eSpark-Backup/ezlo-ambienttrackerpro/README.md

# ezlo-ambienttrackerpro
Convert and do corrections in Ambient Tracker Pro design
