eSpark-Backup/ezlo-ambienttrackerpro/Design-Files/Main-Board-v1.0/BOM/eSpark-BOM-Main-Board-v1.0.xlsx

 |  | Component list |  | Bill of Materials for Project [Main-Board-v1.0]
 |  | Source Data From: |  | Main-Board-v1.0
 |  | Project: |  | Main-Board-v1.0
 |  | Variant: |  | None
# | Item Type | Designator | Description | Footprint | Manufacturer Part Number | Manufacturer | Alternate Part Number | LCSC Part Number | Value | Quantity | Quantity (5 Boards) | MOQ (5 Boards) | Links | Unit Cost (5 Boards) | Total Cost (5 Boards) | Remarks | Reviewer Remarks
1 | Capacitor | C1, C3, C35 | CAP CER 0.1UF 100V X7R 0603 | Cap-0603 | CC0603KRX7R0BB104 | Yageo | - | C113803 | 0.1uF | 3 | 15 | 100 | LCSC (https://www.lcsc.com/product-detail/Multilayer-Ceramic-Capacitors-MLCC-SMD-SMT_YAGEO-CC0603KRX7R0BB104_C113803.html) | $0.0050 | $0.5000
2 | Capacitor | C2 | 15uF 160V ±20% SMD,D10xL10.2mm Aluminum Electrolytic Capacitors - SMD ROHS | Custom | UD2C150M1010 | Honor Elec | - | C98557 | 15uF | 1 | 5 | 10 | LCSC (https://www.lcsc.com/product-detail/Aluminum-Electrolytic-Capacitors-SMD_Honor-Elec-UD2C150M1010_C98557.html) | $0.1212 | $1.2120
3 | Capacitor | C4 | CAP CER 12PF 50V C0G/NPO 0603 | Cap-0603 | CC0603JRNPO9BN120 | Yageo | - | C107034 | 12pF | 1 | 5 | 100 | LCSC (https://www.lcsc.com/product-detail/Multilayer-Ceramic-Capacitors-MLCC-SMD-SMT_YAGEO-CC0603JRNPO9BN120_C107034.html) | $0.0028 | $0.2800
4 | Capacitor | C5 | 470uF 16V ±20% SMD,D8xL10mm Aluminum Electrolytic Capacitors - SMD ROHS | Custom | VZH471M1CTR-0810 | Lelon |  | C164069 | 470uF | 1 | 5 | 10 | LCSC (https://www.lcsc.com/product-detail/Aluminum-Electrolytic-Capacitors-SMD_Lelon-VZH471M1CTR-0810_C164069.html) | $0.1017 | $1.0170
5 | Capacitor | C6, C7, C10, C12, C14, C15, C17, C20, C21, C23, C26, C27, C31, C32, C34, C39, C40, C41, C42, C43, C44, C55, C56 | CAP CER 0.1UF 50V X5R 0402 | Cap-0402 | C1005X5R1H104K050BB | TDK |  | C2181865 | 0.1uF | 23 | 115 |  |  |  | $0.0000
6 | Capacitor | C8 | CAP ALUM 100UF 20% 10V SMD | Custom | UCD1A101MCL1GS | Nichicon |  | C340720 | 100uF | 1 | 5 | 10 | LCSC (https://www.lcsc.com/product-detail/Aluminum-Electrolytic-Capacitors-SMD_Nichicon-UCD1A101MCL1GS_C340720.html) | $0.1604 | $1.6040
7 | Capacitor | C9, C24, C25, C38, C45 | CAP CER 10UF 16V X5R 0603 | Cap-0603 | CC0603KRX5R7BB106 | Yageo |  | C2936601 | 10uF | 5 | 25 |  |  |  | $0.0000
8 | Capacitor | C11 | CAP CER 4700PF 1KV X7R 1206 | Cap-1206 | CC1206KKX7RCBB472 | Yageo |  | C107198 | 4.7nF | 1 | 5 | 50 | LCSC (https://www.lcsc.com/product-detail/Multilayer-Ceramic-Capacitors-MLCC-SMD-SMT_YAGEO-CC1206KKX7RCBB472_C107198.html) | $0.0172 | $0.8600
9 | Capacitor | C13, C16, C18, C19, C22 | CAP CER 10UF 10V X5R 0402 | Cap-0402 | CC0402MRX5R6BB106 | Yageo |  | C962143 | 10uF | 5 | 25 | 40 | LCSC (https://www.lcsc.com/product-detail/Multilayer-Ceramic-Capacitors-MLCC-SMD-SMT_YAGEO-CC0402MRX5R6BB106_C962143.html) | $0.0263 | $1.0520
10 | Capacitor | C30 | CAP CER 22UF 10V X5R 0603 | Cap-0603 | CC0603MRX5R6BB226 | Yageo |  | C109447 | 22uF | 1 | 5 | 20 | LCSC (https://www.lcsc.com/product-detail/Multilayer-Ceramic-Capacitors-MLCC-SMD-SMT_YAGEO-CC0603MRX5R6BB226_C109447.html) | $0.0339 | $0.6780
11 | Capacitor | C33 | CAP CER 1UF 10V X5R 0402 | Cap-0402 | CC0402KRX5R6BB105 | Yageo |  | C106254 | 1uF | 1 | 5 | 100 | LCSC (https://www.lcsc.com/product-detail/Multilayer-Ceramic-Capacitors-MLCC-SMD-SMT_YAGEO-CC0402KRX5R6BB105_C106254.html) | $0.0025 | $0.2500
12 | Capacitor | C36, C37 | CAP CER 22UF 25V X5R 0805 | Cap-0805 | CC0805MKX5R8BB226 | Yageo |  | C784585 | 22uF | 2 | 10 | 20 | LCSC (https://www.lcsc.com/product-detail/Multilayer-Ceramic-Capacitors-MLCC-SMD-SMT_YAGEO-CC0805MKX5R8BB226_C784585.html) | $0.0659 | $1.3180
13 | Capacitor | C46, C47 | 50V 6.8nF X7R ±10% 0603 | Cap-0603 | 0603B682K500NT | FH |  | C1631 | 6.8nF | 2 | 10 | 100 | LCSC (https://www.lcsc.com/product-detail/Multilayer-Ceramic-Capacitors-MLCC-SMD-SMT_FH-Guangdong-Fenghua-Advanced-Tech-0603B682K500NT_C1631.html) | $0.0026 | $0.2600
14 | Capacitor | C48, C50 | CAP CER 10000PF 50V C0G/NPO 0603 | Cap-0603 | CC0603JRNPO9BN103 | Yageo |  | C389113 | 10nF | 2 | 10 | 50 | LCSC (https://www.lcsc.com/product-detail/Multilayer-Ceramic-Capacitors-MLCC-SMD-SMT_YAGEO-CC0603JRNPO9BN103_C389113.html) | $0.0146 | $0.7300
15 | Capacitor | C49 | CAP CER 0.022UF 50V X7R 0603 | Cap-0603 | CC0603KRX7R9BB223 | Yageo |  | C106222 | 22nF | 1 | 5 | 100 | LCSC (https://www.lcsc.com/product-detail/Multilayer-Ceramic-Capacitors-MLCC-SMD-SMT_YAGEO-CC0603KRX7R9BB223_C106222.html) | $0.0031 | $0.3100
16 | Capacitor | C51 | CAP CER 4.7UF 10V X5R 0603 | Cap-0603 | CC0603KRX5R6BB475 | Yageo |  | C109456 | 4.7uF | 1 | 5 | 50 | LCSC (https://www.lcsc.com/product-detail/Multilayer-Ceramic-Capacitors-MLCC-SMD-SMT_YAGEO-CC0603KRX5R6BB475_C109456.html) | $0.0149 | $0.7450
17 | Capacitor | C52, C53 | Multilayer Ceramic Capacitor, 12 pF, 50 V, ± 5%, C0G (NP0), 0201 [0603 Metric] | CAP-0201 | GRM0335C1H120JA01D | Murata |  | C85890 | 12pF | 2 | 10 | 100 | LCSC (https://www.lcsc.com/product-detail/Multilayer-Ceramic-Capacitors-MLCC-SMD-SMT_Murata-Electronics-GRM0335C1H120JA01D_C85890.html) | $0.0020 | $0.2000
18 | Capacitor | C54 | CAP CER 1000PF 2KV X7R 1206 | Cap-1206 | CC1206KKX7RDBB102 | Yageo |  | C23631 | 1000pF | 1 | 5 | 50 | LCSC (https://www.lcsc.com/product-detail/Multilayer-Ceramic-Capacitors-MLCC-SMD-SMT_YAGEO-CC1206KKX7RDBB102_C23631.html) | $0.0148 | $0.7400
19 | ~~Capacitor~~ | ~~C?~~ | ~~100V 220pF X7R ±10% 0603 Multilayer Ceramic Capacitors MLCC - SMD/SMT ROHS~~ | ~~Cap-0603~~ | ~~0603B221K101NT~~ | ~~FH~~ |  | ~~C313082~~ | ~~DNP~~ | ~~1~~ | ~~5~~ | ~~-~~ |  | ~~-~~ | ~~-~~ | ~~Do Not Place~~
20 | Diode | D2 | 93.6V 64.4V 58V SMA(DO-214AC) TVS ROHS | SMA | SMAJ58A | Yangzhou Yangjie Elec Tech |  | C698958 |  | 1 | 5 | 10 | LCSC (https://www.lcsc.com/product-detail/TVS_Yangzhou-Yangjie-Elec-Tech-SMAJ58A_C698958.html) | $0.0463 | $0.4630
21 | Diode | D3 | SCHOTTKY DIODE SMB 100V 5A | SMB_ | SS510B | MDD |  | C3011128 |  | 1 | 5 | 10 | LCSC (https://www.lcsc.com/product-detail/Schottky-Barrier-Diodes-SBD_JUXING-SS510B_C3011128.html) | $0.0267 | $0.2670
22 | Diode | D4 | SOD-123FL Schottky Barrier Diodes (SBD) ROHS | SOD-123FL | PMEG4030ER | Shikues |  | C5366303 |  | 1 | 5 | 10 | LCSC (https://www.lcsc.com/product-detail/Schottky-Barrier-Diodes-SBD_Shikues-PMEG4030ER_C5366303.html) | $0.0519 | $0.5190
23 |  | D5 | ESD Suppressor TVS 5.5V 4-Pin(3+Tab) SOT-143 T/R | SOT-143-4_ | SP0503BAHTG | Littelfuse |  | C3029025 |  | 1 | 5 | 10 | LCSC (https://www.lcsc.com/product-detail/ESD-Protection-Devices_MSKSEMI-SP0503BAHTG-MS_C3029025.html) | $0.0865 | $0.8650
24 | Fuse | F1, F2 | 6V 2A 50A 1W -40℃~+85℃ 4A 4mΩ 5s 45mΩ 0805 Resettable Fuses ROHS | Fuse-0805 | BSMD0805L-200 | BHFUSE |  | C2757931 |  | 2 | 10 | 15 | LCSC (https://www.lcsc.com/product-detail/Resettable-Fuses_BHFUSE-BSMD0805L-200_C2757931.html) | $0.0930 | $1.3950
25 | Ferrite Bead | FB1, FB4 | FERRITE BEAD 120 OHM 0603 1LN | IND-0603 (1608 Metric) | BLM18SG121TN1D | Murata |  | C113030 |  | 2 | 10 | 20 |  |  | $0.0000
26 | Ferrite Bead | FB2, FB3, FB7, FB8 | FERRITE BEAD 120 OHM 0402 1LN | IND-0402 | BLM15PD121SN1D | Murata |  | C76891 |  | 4 | 20 |  |  |  | $0.0000
27 | Ferrite Bead | FB5, FB6 | 100mΩ ±25% 600Ω@100MHz 0805 Ferrite Beads ROHS | Ind-0805 | CBM201209U601T | FH |  | C139168 |  | 2 | 10 |  |  |  | $0.0000
28 | USB Connector | J1 | 250mA 1 16 Female Type-C SMD USB Connectors ROHS | TYPE-C-31-M-12_ | TYPE-C-31-M-12 | Korean Hroparts Elec |  | C165948 |  | 1 | 5 |  |  |  | $0.0000
29 | FFC/FPC Connector | J2 | Clamshell 14P Bottom Contact Surface Mount 0.5mm SMD,P=0.5mm FFC/FPC Connectors ROHS | AFC01-S14FCC-00 | AFC01-S14FCC-00 | JUSHUO |  | C577443 |  | 1 | 5 |  |  |  | $0.0000
30 | R/A Male Blade Header | J3 | CONN HEADER SMD R/A 8POS 1.25MM | 53261-0871 | 53261-0871 | Molex |  |  |  | 1 | 5 |  |  |  | $0.0000
31 | Connector | J4 | 1x6P SH 1 1mm 6 SMD,P=1mm Wire To Board / Wire To Wire Connector ROHS | Voltlink Target | C145963 | BOOMELE |  | C145963 |  | 1 | 5 |  |  |  | $0.0000
32 | Ethernet Connector | J5 | 1x1 Port Tab-UP RJ45 Connector with Integrated Magnetics and LED for 10/100Base-T PoE application | HR873170C | HR873170C | Hanrun |  |  |  | 1 | 5 |  |  |  | $0.0000
33 | Inductor | L1 | 3A 33uH ±20% 64.8mΩ SMD,12.3x12.3mm Inductors (SMD) ROHS | CYH127-33UH | CYH127-33UH | SHOU HAN |  | C2929502 | 33uH | 1 | 5 |  |  |  | $0.0000
34 | Inductor | L2 | FIXED IND 10UH 1A 540 MOHM SMD | IND-1008 (2520 Metric) | VLS252012HBX-100M-1 | TDK |  | C88532 | 10uH | 1 | 5 |  |  |  | $0.0000
35 | RGB LED | LED1 | 5mA -40℃~+80℃ RGB SMD,2x2mm Light Emitting Diodes (LED) ROHS | SK6812-EC20 | SK6812-EC20 | OPSCO Optoelectronics |  | C2909058 |  | 1 | 5 |  |  |  | $0.0000
36 | LED | LED2 | LED GREEN CLEAR CHIP SMD | LED-0402 | XZVG68W-2 | SunLED |  |  |  | 1 | 5 |  |  |  | $0.0000
37 | TEST POINT | P1, P2, P3, P4, P5, P6, P7, P8, P9, P10, P11, P12, P13, P14, P15, P16, P17, P18, P19, P20, P21, P22, P23, P24, P25, P26, P27, P28, P29, P30, P31, P32, P33 | Test Point ON | Test-point |  |  |  |  |  | 33 | 165 |  |  |  | $0.0000
38 | Mosfet | Q1 | SOT-23-3 MOSFETs ROHS | SOT-23 | SI2323DS | TECH PUBLIC |  | C5182044 |  | 1 | 5 |  |  |  | $0.0000
39 | Mosfet | Q2 | N-CHANNEL 20-V (D-S) MOSFET | Sot-23 | SI2302CDS | TECH PUBLIC |  | C5310968 |  | 1 | 5 |  |  |  | $0.0000
40 | Mosfet | Q3 | NPN 246mW 100mA 50V SOT-23 Digital Transistors ROHS | SOT-23 | LMUN2211LT1G | LRC |  | C12775 |  | 1 | 5 |  |  |  | $0.0000
41 | Mosfet | Q4 | 20V 2.2A 800mW 110mΩ@4.5V,2.7A 810mV@250uA P Channel SOT-23 MOSFETs ROHS | Sot-23 | WPM2015-3/TR | WILLSEMI |  | C213159 |  | 1 | 5 |  |  |  | $0.0000
42 | Resistor | R1 | RES 4.7 OHM 1% 1/10W 0603 | Res-0603 | RC0603FR-074R7L | Yageo |  | C137705 | 4.7R | 1 | 5 |  |  |  | $0.0000
43 |  | R2 | RES SMD 24.9K OHM 1% 1/5W 0402 | Res-0402 | RCS040224K9FKED | Vishay Dale |  | C1881100 | 24.9K | 1 | 5 |  |  |  | $0.0000
44 | Resistor | R3, R23, R24 | RES SMD 4.7K OHM 1% 1/10W 0603 | Res-0603 | RC0603FR-074K7L | Yageo |  | C99782 | 4.7K | 3 | 15 |  |  |  | $0.0000
45 | Resistor | R4 | RES 0.03 OHM 1% 1/2W 0805 | RES-0805 | PE0805FRF470R03L | Yageo |  | C858599 | 30mR | 1 | 5 |  |  |  | $0.0000
46 | Resistor | R5 | RES SMD 301 OHM 0.1% 1/10W 0603 | Res-0603 | RT0603BRE07301RL | YAGEO |  | C861824 | 301R | 1 | 5 |  |  |  | $0.0000
47 | Resistor | R6 | RES 180K OHM 1% 1/10W 0603 | Res-0603 | RC0603FR-07180KL | Yageo |  | C123419 | 180K | 1 | 5 |  |  |  | $0.0000
48 | Resistor | R7 | RES SMD 4.42K OHM 1% 1/10W 0603 | Res-0603 | AC0603FR-074K42L | Yageo |  | C227930 | 4.42K | 1 | 5 |  |  |  | $0.0000
49 | Resistor | R8 | RES SMD 57.6KOHM 0.1% 1/10W 0603 | Res-0603 | RT0603BRE0757K6L | YAGEO |  | C849817 | 57.6K | 1 | 5 |  |  |  | $0.0000
50 | Resistor | R9, R17, R18, R19, R27, R36, R38 | RES 10K OHM 1% 1/16W 0402 | Res-0402 | RC0402FR-0710KL | Yageo |  | C60490 | 10K | 7 | 35 |  |  |  | $0.0000
51 | Resistor | R10, R25 | RES 100K OHM 5% 1/10W 0603 | Res-0603 | RC0603JR-07100KL | Yageo |  | C100048 | 100K | 2 | 10 |  |  |  | $0.0000
52 | Resistor | R11, R12 | RES 5.1K OHM 1% 1/16W 0402 | Res-0402 | RC0402FR-075K1L | Yageo |  | C137973 | 5.1K | 2 | 10 |  |  |  | $0.0000
53 | Resistor | R13 | RES SMD 1M OHM 1% 1/10W 0603 | Res-0603 | RC0603FR-071ML | Yageo |  | C105578 | 1M | 1 | 5 |  |  |  | $0.0000
54 | Resistor | R14, R15, R21 | RES SMD 10K Ohm 1% 1/10W 0603 | Res-0603 | RC0603FR-0710KL | Yageo |  | C98220 | 10K | 3 | 15 |  |  |  | $0.0000
55 | Resistor | R20, R22, R26 | RES SMD 1K OHM 1% 1/10W 0603 | Res-0603 | RC0603FR-071KL | Yageo |  | C22548 | 1K | 3 | 15 |  |  |  | $0.0000
56 | Resistor | R28 | RES SMD 0R, 1%, 0.1W, 0603 | Res-0603 | RC0603FR-070RL | Yageo |  | C100044 | DNP | 1 | 5 |  |  |  | $0.0000
57 | Resistor | R29, R30, R31, R34 | RES SMD 0603 33 Ohm 1% 1/10W | Res-0603 | RC0603FR-0733RL | Yageo |  | C108661 | 33R | 4 | 20 |  |  |  | $0.0000
58 | Resistor | R32, R33, R35, R37 | RES 49.9 OHM 1% 1/10W 0603 | Res-0603 | RC0603FR-0749R9L | Yageo |  | C114625 | 49.9R | 4 | 20 |  |  |  | $0.0000
59 | Resistor | R39 | RES SMD 10 OHM 1% 1/10W 0603 | Res-0603 | RC0603FR-0710RL | Yageo |  | C109318 | 10R | 1 | 5 |  |  |  | $0.0000
60 | Resistor | R40 | Res Thick Film 0402 1M Ohm 1% 0.1W(1/10W) ±100ppm/C Pad SMD Automotive T/R | Res-0402 | RK73H1ETTP1004F | KOA Speer |  | C159943 | 1M | 1 | 5 |  |  |  | $0.0000
61 | Resistor | R41, R43 | RES SMD 330R 100 mW 0603 | Res-0603 | RC0603JR-07330RL | Yageo |  | C105879 | 330R | 2 | 10 |  |  |  | $0.0000
62 | Resistor | R42, R45 | RES SMD 0R, 1%, 0.1W, 0603 | Res-0603 | RC0603FR-070RL | Yageo |  | C100044 | 0R | 2 | 10 |  |  |  | $0.0000
63 | Resistor | R44 | RES SMD 12.4K OHM 1% 1/10W 0603 | Res-0603 | RC0603FR-0712K4L | Yageo |  | C137798 | 12.4K | 1 | 5 |  |  |  | $0.0000
64 | Resistor | R? | RES 22 OHM 1% 1/16W 0402 | Res-0402 | RC0402FR-0722RL | Yageo |  | C114765 | DNP | 1 | 5 |  |  |  | $0.0000
65 | Resistor Array | RN1, RN2, RN3 | RES ARRAY 4 RES 10K OHM 1206 | YC164-FR-0710KL | YC164-FR-0710KL | Yageo |  | C110924 | 10K | 3 | 15 |  |  |  | $0.0000
66 | Tactile Switch | SW1 | 50mA 100MΩ 100000 Times 260gf@±50gf 12V Surface Mount SPST SMD Tactile Switches ROHS | TP12422673 | TP12422673 | ROCPU Switch |  | C5381384 |  | 1 | 5 |  |  |  | $0.0000
67 | IC | U1 | Step-down type SOIC-8-EP DC-DC Converters ROHS | 8-SOIC-EP | TX4138 | XDS |  | C329267 |  | 1 | 5 |  |  |  | $0.0000
68 | IC | U2 | IC POE CNTRL 1 CHANNEL 8SOIC | SOIC-8 | TPS2375DR | Texas Instruments |  | C2867397 |  | 1 | 5 |  |  |  | $0.0000
69 | IC | U3 | 600mA 60dB 500mV@(600mA) Fixed 3.3V~3.3V Positive 1 7V SOT-89(SOT-89-3) Linear Voltage Regulators (LDO) ROHS | SOT-89-3 | LR1107G-33-AB3-C-R | UTC(Unisonic Tech) |  | C171498 |  | 1 | 5 |  |  |  | $0.0000
70 | IC | U4 | 300mA 80dB@(1kHz) 410mV@(300mA) Fixed 1.8V~1.8V Positive 1 5.5V SOT-25-5 Linear Voltage Regulators (LDO) ROHS | SOT-25-5 | XC6228D182VR-G | Torex Semicon |  | C216644 |  | 1 | 5 |  |  |  | $0.0000
71 | IC | U5 | 300mA 80dB@(1kHz) 305mV@(300mA) Fixed 3.3V~3.3V Positive 1 5.5V SOT-25-5 Linear Voltage Regulators (LDO) ROHS | SOT-25-5 | XC6228D332VR-G | Torex Semicon |  | C69841 |  | 1 | 5 |  |  |  | $0.0000
72 | Temperature Sensor | U7 | SENSOR RH PRESSURE TEMP VOC | BME680 | BME680 | Bosch Sensortec |  | C125972 |  | 1 | 5 |  |  |  | $0.0000
73 | Module | U8 | SMD MODULE, ESP32-S3R8 WITH 3.3V | 41-SMD Module | ESP32-S3-WROOM-1-N16R8 | Espressif Systems |  | C2913202 |  | 1 | 5 |  |  |  | $0.0000
74 | Module | U9 | RF Modules ENGINEERING SAMPLE | DWM3000_ESSR | DWM3000-ESSR | Qorvo |  |  |  | 1 | 5 |  |  |  | $0.0000
75 | IC | U10 | SPI LQFP-48(7x7) Ethernet ICs ROHS | 48-LQFP (7x7)_ | W5500 | WIZNET |  | C32843 |  | 1 | 5 |  |  |  | $0.0000
76 | TVS Diode | U11 | TVS DIODE 5.5VWM 8.5VC SOT23-5 | SOT-23-5 | SP0504BAHTG | Littelfuse |  | C10675 |  | 1 | 5 |  |  |  | $0.0000
77 | IC | U12 | IC TRANSLATOR BIDIR 20TSSOP | TSSOP-20 | TXS0108EPWR | Texas Instruments |  | C17206 |  | 1 | 5 |  |  |  | $0.0000
78 | Crystal | X1 | CRYSTAL 25.0000MHZ 12PF SMD | Q22FA12800090 | Q22FA12800090 | Seiko Epson |  | C255883 | 25MHz | 1 | 5 |  |  |  | $0.0000
 |  |  |  |  |  |  |  |  |  |  |  | Total Component Cost |  |  | #REF!
 |  |  |  |  |  |  |  |  |  |  |  | Single Board Cost |  |  | #REF!
