eSpark-Backup/ezlo-ambienttrackerpro/Client-Files/Ambient Tracker PRO/BOM/JLCSMT_BOM_tracker_revA.xlsx

Comment | Designator | Footprint | LCSC Part #（optional）
0.1uF | C1, C2, C9, C11, C13, C14, C16, C18, C19, C20, C21, C25, C30, C31, C34, C35, C36, C37, C46, C47, C48, C50, C51, C52, C54, | Capacitor_SMD:C_0402_1005Metric | C307331
1uF | C3, C32, | Capacitor_SMD:C_0402_1005Metric | C52923
10uF | C4, C5, C26, C45, C55, | Capacitor_SMD:C_0603_1608Metric | C92487
10uF | C6, C8, C12, C17, C24, | Capacitor_SMD:C_0402_1005Metric | C315248
4.7nF | C7, | Capacitor_SMD:C_1206_3216Metric | C107198
0.1uF | C10, C22, | Capacitor_SMD:C_0603_1608Metric | C15725
15uF | C15, | Capacitor_SMD:CP_Elec_10x10 | C473415
220pF | C23, | Capacitor_SMD:C_0603_1608Metric | DNP | C472787
12pF | C27, C56, C57, | Capacitor_SMD:C_0402_1005Metric | C1547
470uF | C28, | Capacitor_SMD:CP_Elec_8x10 | C164069
100uF | C29, | Capacitor_SMD:CP_Elec_6.3x5.8 | C340720
22uF | C33, | Capacitor_SMD:C_1206_3216Metric | C408152
1nF 2KV X7R | C38, | Capacitor_SMD:C_1206_3216Metric | C23631
6.8nF | C39, C40, | Capacitor_SMD:C_0402_1005Metric | C307331
22uF | C41, C44, | Capacitor_SMD:C_0603_1608Metric | C59461
10nF | C42, C49, | Capacitor_SMD:C_0402_1005Metric | C307331
22nF | C43, | Capacitor_SMD:C_0402_1005Metric | C307331
4.7uF | C53, | Capacitor_SMD:C_0603_1608Metric | C19666
SMAJ58A | D1, | Diode_SMD:D_SMA | C320541
SP0503BAHT | D2, | Package_TO_SOT_SMD:SOT-143 | C2682275
PMEG4030ER | D3, | Diode_SMD:D_SOD-123 | C389355
SS510 | D4, | Diode_SMD:D_SMC | C717458
LED_GREEN | D5, | LED_SMD:LED_0603_1608Metric | C84267
SK6812-EC20 | D6, | Ezlo:sk6812-2020 | C2909058
SP0504BAHT | D7, | Package_TO_SOT_SMD:SOT-23-5 | C2827708
1A | F1, F2, | Fuse:Fuse_0805_2012Metric | C369152
BLM18SG121TN1D | FB1, FB4, | Inductor_SMD:L_0603_1608Metric | C113030
BLM15PD121SN1B | FB2, FB3, FB5, FB6, | Inductor_SMD:L_0402_1005Metric | C76891
600R 3A | FB7, FB8, | Inductor_SMD:L_0805_2012Metric | C139168
Conn_01x10 | J1, | Ezlo:AFC01-S10FCC-00_1x10_P0.5mm_Horizontal | C262266
USB_C_Receptacle_USB2.0 | J3, | Ezlo:USB_C_Receptacle_HRO_TYPE-C-31-M-12 | C165948
VoltLink_target | J4, | Voltlog:VoltLink-vertical | C145963
10uH | L1, | Inductor_SMD:L_1008_2520Metric | C88532
33uH 2A | L2, | Inductor_SMD:L_Bourns_SRR1208_12.7x12.7mm | C2929502
SI2323DS | Q1, | Package_TO_SOT_SMD:SOT-23 | C693130
Si2302CDS | Q2, | Package_TO_SOT_SMD:SOT-23 | C10488
WPM2015-3 | Q3, | Package_TO_SOT_SMD:SOT-23 | C5246393
LMUN2211LT1G | Q4, | Package_TO_SOT_SMD:SOT-23 | C12775
10K | R1, R2, R3, R12, R19, R21, R24, R25, R30, R39, R41, | Resistor_SMD:R_0402_1005Metric | C25744
1M | R4, | Resistor_SMD:R_1206_3216Metric | C17927
5K1 | R5, R6, | Resistor_SMD:R_0402_1005Metric | C25905
180K | R7, | Resistor_SMD:R_0402_1005Metric | C284388
24K9 | R8, | Resistor_SMD:R_0402_1005Metric | C25874
4K42 | R9, | Resistor_SMD:R_0402_1005Metric | C517779
4K7 | R10, | Resistor_SMD:R_2512_6332Metric | C473645
0.03R | R11, | Resistor_SMD:R_1206_3216Metric | C473665
100K | R13, R27, | Resistor_SMD:R_0402_1005Metric | C25741
4R7 | R14, | Resistor_SMD:R_0402_1005Metric | C25169
22R | R15, | Resistor_SMD:R_0402_1005Metric | DNP | C25092
301K | R16, | Resistor_SMD:R_0402_1005Metric | C226978
57K6 | R17, | Resistor_SMD:R_0402_1005Metric | C26983
0R | R18, R42, | Resistor_SMD:R_0402_1005Metric | C17168
1K | R26, R34, | Resistor_SMD:R_0402_1005Metric | C25905
1K | R20 | Resistor_SMD:R_0402_1005Metric | DNP
4K7 | R22, R23, | Resistor_SMD:R_0402_1005Metric | C25900
330R | R28, R29, | Resistor_SMD:R_0402_1005Metric | C25104
0R | R31, | Resistor_SMD:R_0805_2012Metric | DNP | C17477
49R9 | R32, R33, R36, R37, | Resistor_SMD:R_0402_1005Metric | C25120
10R | R35, | Resistor_SMD:R_0402_1005Metric | C25077
12K4 | R38, | Resistor_SMD:R_0402_1005Metric | C11692
1M | R40, | Resistor_SMD:R_0402_1005Metric | C26083
0R | RN1, RN2, | Resistor_SMD:R_Array_Concave_4x0603 | C327053
33R | RN3, | Resistor_SMD:R_Array_Concave_4x0603 | C309681
10K | RN4, RN5, RN6, | Resistor_SMD:R_Array_Concave_4x0603 | C110924
USER | SW1, | Ezlo:Switch_YTS-B003-2A | C2910695
BME680 | U1, | Package_LGA:Bosch_LGA-8_3x3mm_P0.8mm_ClockwisePinNumbering | C125972
LTR-303ALS-01 | U2, | OptoDevice:Lite-On_LTR-303ALS-01 | C364577
XC6228D332VR-G | U3, | Package_TO_SOT_SMD:SOT-23-5 | C69841
TPS2375PW-1 | U4, | Package_SO:TSSOP-8_4.4x3mm_P0.65mm | C202190
XC6228D182VR-G | U5, | Package_TO_SOT_SMD:SOT-23-5 | C216644
TX4138 | U6, | Package_SO:Diodes_SO-8EP | C329267
LR1107 | U7, | Package_TO_SOT_SMD:SOT-89-3 | C171498
TXS0108EPWR | U8, | Package_SO:TSSOP-20_4.4x6.5mm_P0.65mm | C17206
ESP32-S3-WROOM-1-N8R2 | U9, | Espressif:ESP32-S3-WROOM-1 | C2913204
DWM3000 | U10, | Ezlo:Qorvo_DWM3000 | C5299931
W5500 | U11, | Package_QFP:LQFP-48_7x7mm_P0.5mm | C32843
25Mhz | Y1, | Crystal:Crystal_SMD_2016-4Pin_2.0x1.6mm | C255883
