eSpark-Backup/ezlo-ambienttrackerpro/Design-Files/Main-Board-v1.0/AmbientPro_Main_Board_V1.0.step

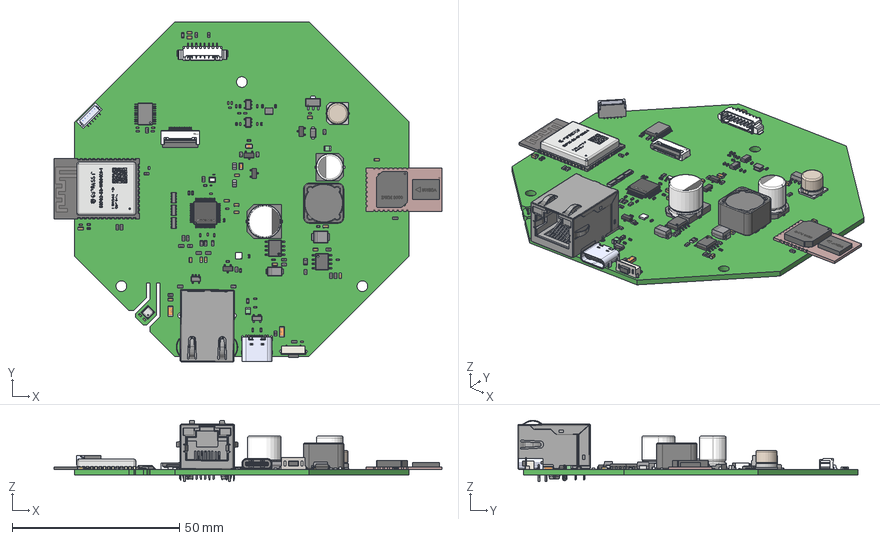
[picture p1: CAD file, 2023-11-29]
Design-Files/Main-Board-v1.0/AmbientPro_Main_Board_V1.0.step
115.9 x 101.7 x 18.3 mm
YC164-JR-070RL x 3
User Library-sot25 x 2
User Library-XRCGB27M000F2P00R0
TXS0108EPWR
SN74LV1T34DBVR
User Library-P-LQFP48-7x7-0_50
COMPOUND-49^DWM3000
ESP-S3-WROOM_via v3 x 26
ESP32-S3-WROOM_shell v11
ESP32-S3-WROOM_body v12
ESP-S3-WROOM_via v3(镜像) x 14
BME680--3DModel-STEP-56544
User_Library_SOT89_5005
User Library-SOIC-8-1 x 2
Switch
User Library-RES_1005-0402 x 12
User Library-RESC1608X05N x 32
User Library-CR2012-0805
CircuitWorks-SOT-23 x 4
User Library-LED-0402
OPSCO-Optoelectronics-SK6812-EC20_C2909058
VLS252012HBX-100M
SHOU HAN CYH127-33UH
HR873170C.dwg
SOLID.step.STEP.dwg.STEP.STEP.dwg
532610871--3DModel-STEP-269445
COMPOUND.step
TYPE-C-31-M-12
User Library-d0402h025 x 4
Lötende x 4
base x 2
User Library-fuse0805L050WR x 2
SP0503BAHTG--3DModel-STEP-56544 (1)
User Library-SOD-123FL CASE 498
User Library-DO-214AA SMB
User Library-DO-214AC SMA
User Library-CAPC1608X09 x 17
User Library-Capacitor 0402 x 29
User Library-1206 SMD Capacitor x 2
User Library-SMD Ceramic Capacitors_0201 (0603)_AB x 2
User Library-0805 SMD Capacitor x 2
UCD1A101MCL1GS3
SOLID.step
