eSpark-Backup/ezlo-ambienttrackerpro/Design-Files/Secondary-Board-v1.0/AmbientPro_Secondary_Board_V1.0.step

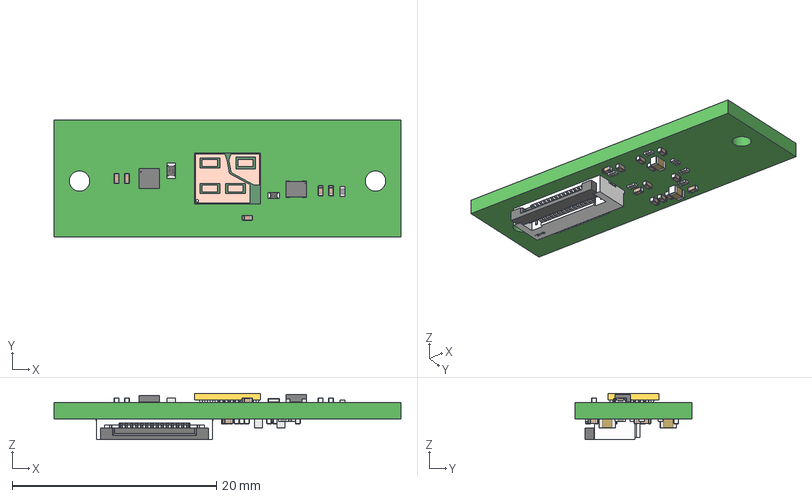
[picture p2: CAD file, 2023-11-29]
Design-Files/Secondary-Board-v1.0/AmbientPro_Secondary_Board_V1.0.step
34.0 x 11.5 x 4.51 mm
KC2016K_KYO
User Library-RES_1005-0402
User Library-Capacitor 0402 x 17
LTR-303ALS-01_LTO
User Library-RESC1608X05N
COMPOUND.step
User Library-d0402h025 x 7
User Library-CAPC1608X09 x 2
