eSpark-Backup/ezlo-ambienttrackerpro/Client-Files/Ambient Tracker PRO/sch-ambient-tracker-pro-revA.pdf

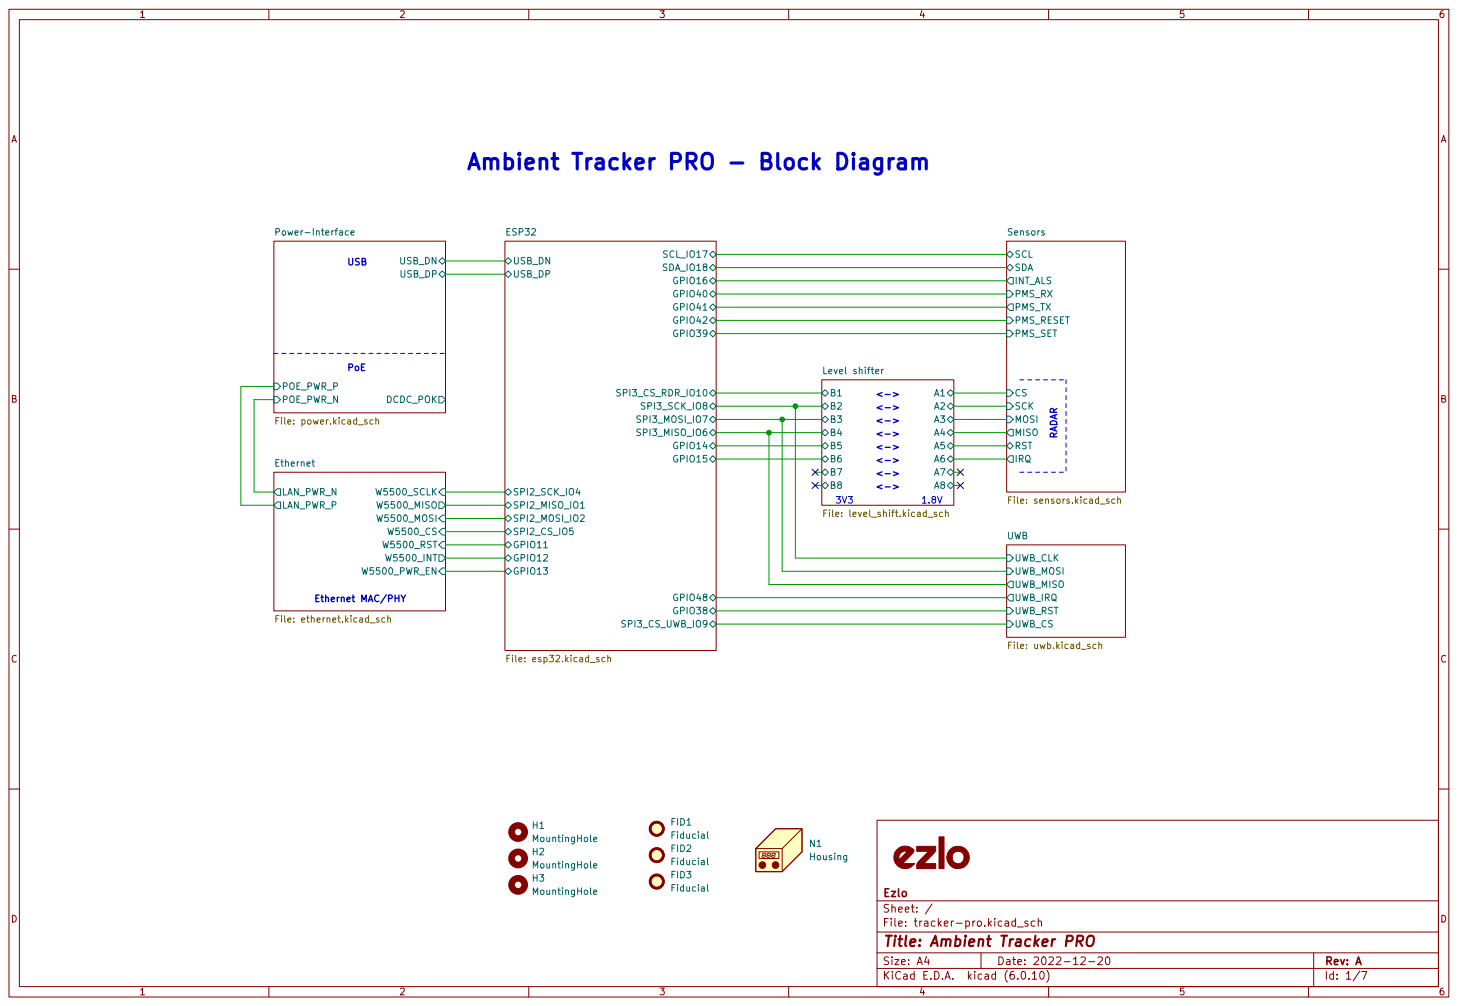
[picture p3: page 1]

<-> Ambient Tracker PRO - Block Diagram

File: tracker-pro.kicad_sch Sheet: / Ezlo

Id: 1/7 Title: Ambient Tracker PRO

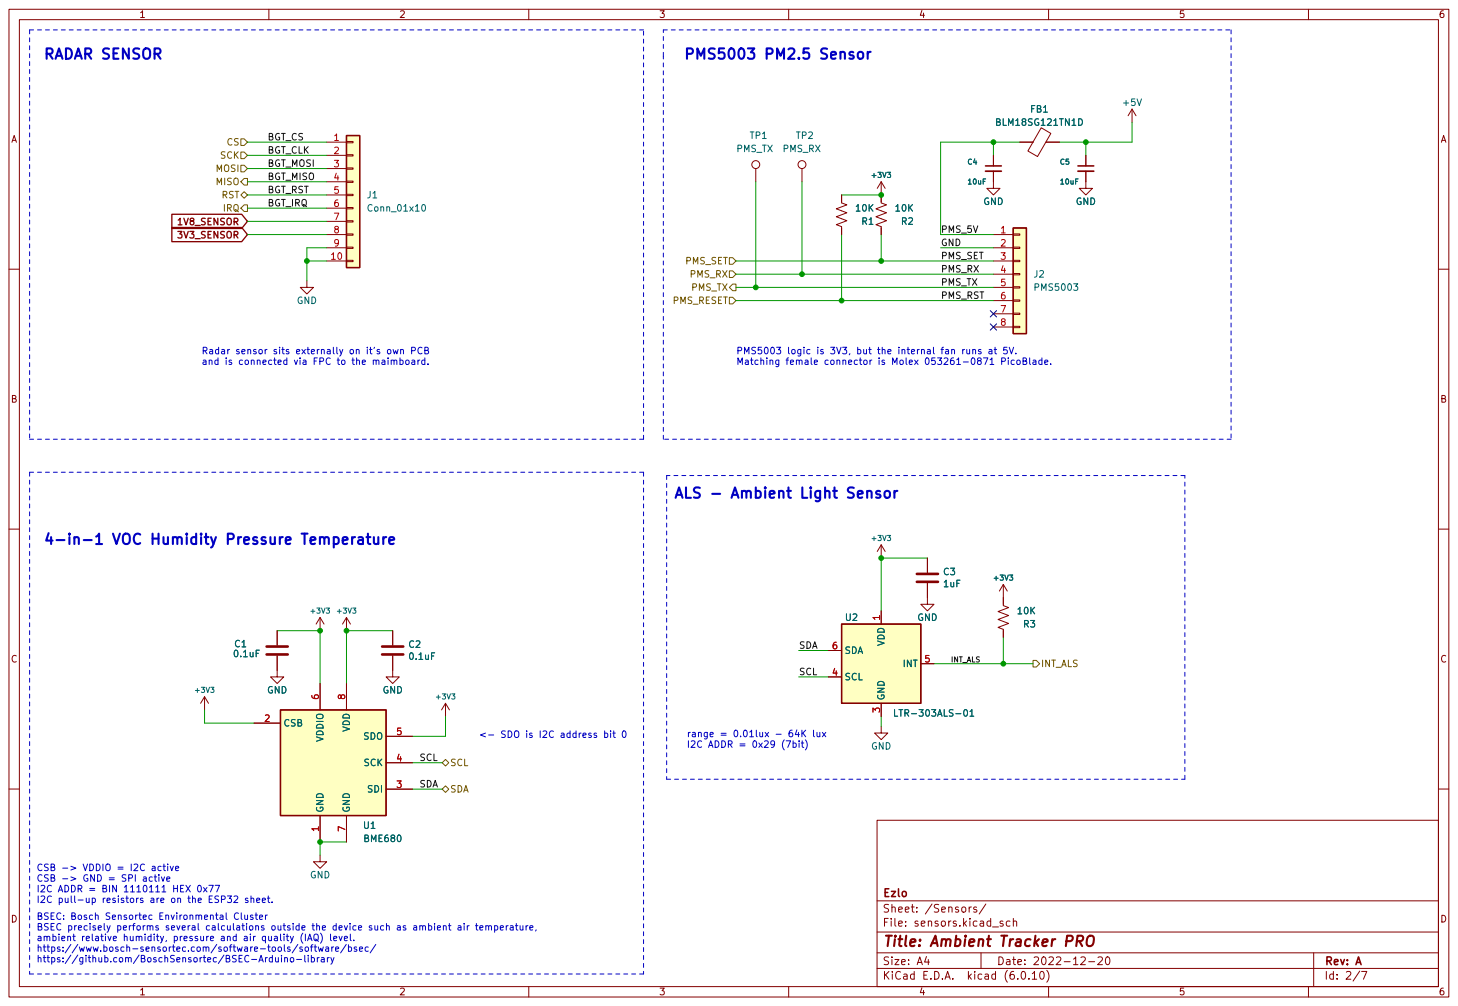
[picture p4: page 2]

and is connected via FPC to the maimboard. RADAR SENSOR

PMS_RESET PMS_RX MOSI SCK RST MISO

Matching female connector is Molex 053261-0871 PicoBlade. <- SDO is I2C address bit 0 Radar sensor sits externally on it's own PCB

PMS5003 logic is 3V3, but the internal fan runs at 5V.

ALS - Ambient Light Sensor

4-in-1 VOC Humidity Pressure Temperature

1 CSB 2 SDI 3 SCK 4 SDO 5 VDDIO

https://github.com/BoschSensortec/BSEC-Arduino-library CSB -> VDDIO = I2C active CSB -> GND = SPI active

I2C ADDR = BIN 1110111 HEX 0x77
I2C pull-up resistors are on the ESP32 sheet.
BSEC: Bosch Sensortec Environmental Cluster BSEC precisely performs several calculations outside the device such as ambient air temperature,
ambient relative humidity, pressure and air quality (IAQ) level.
https://www.bosch-sensortec.com/software-tools/software/bsec/

File: sensors.kicad_sch Sheet: /Sensors/ Ezlo

Id: 2/7 Title: Ambient Tracker PRO

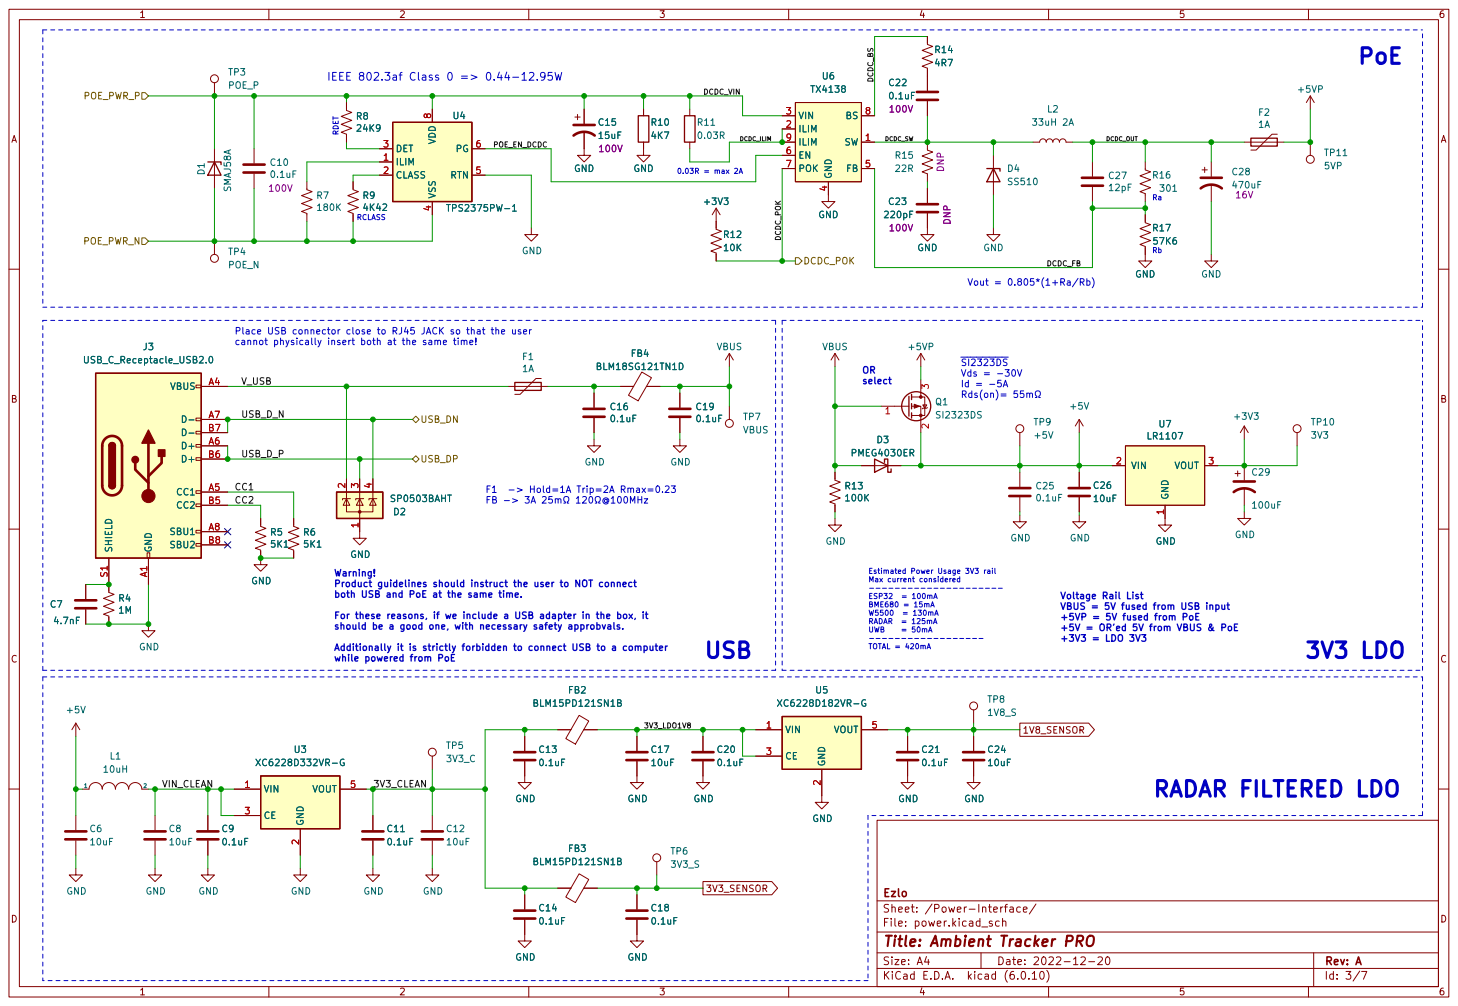
[picture p5: page 3]

TP3 POE_PGND
while powered from PoE RDET

4 FB 5 EN 6 POK 7 BS 8

RCLASS Place USB connector close to RJ45 JACK so that the user cannot physically insert both at the same time!

Warning!
Product guidelines should instruct the user to NOT connect both USB and PoE at the same time. For these reasons, if we include a USB adapter in the box, it

Estimated Power Usage 3V3 rail Max current considered

Voltage Rail List
VBUS = 5V fused from USB input +5VP = 5V fused from PoE

should be a good one, with necessary safety approbvals.

+5V = OR'ed 5V from VBUS & PoE

Additionally it is strictly forbidden to connect USB to a computer

File: power.kicad_sch Sheet: /Power-Interface/ Ezlo

Id: 3/7 Title: Ambient Tracker PRO

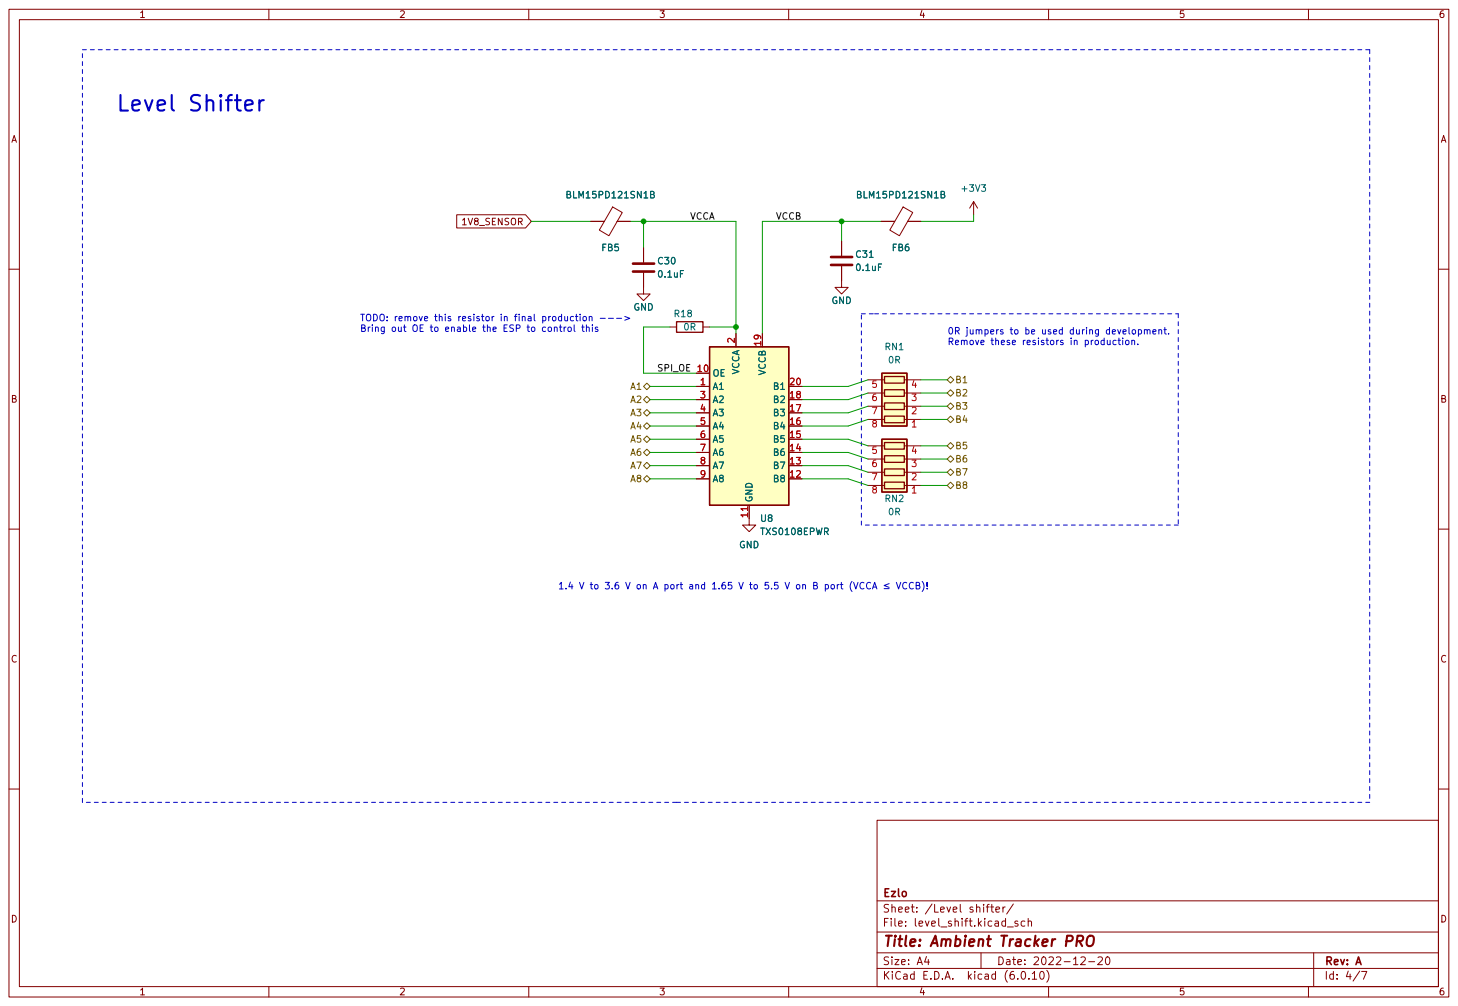
[picture p6: page 4]

TODO: remove this resistor in final production --->

0R jumpers to be used during development.
Remove these resistors in production.

File: level_shift.kicad_sch Sheet: /Level shifter/ Ezlo GND

Id: 4/7 Title: Ambient Tracker PRO

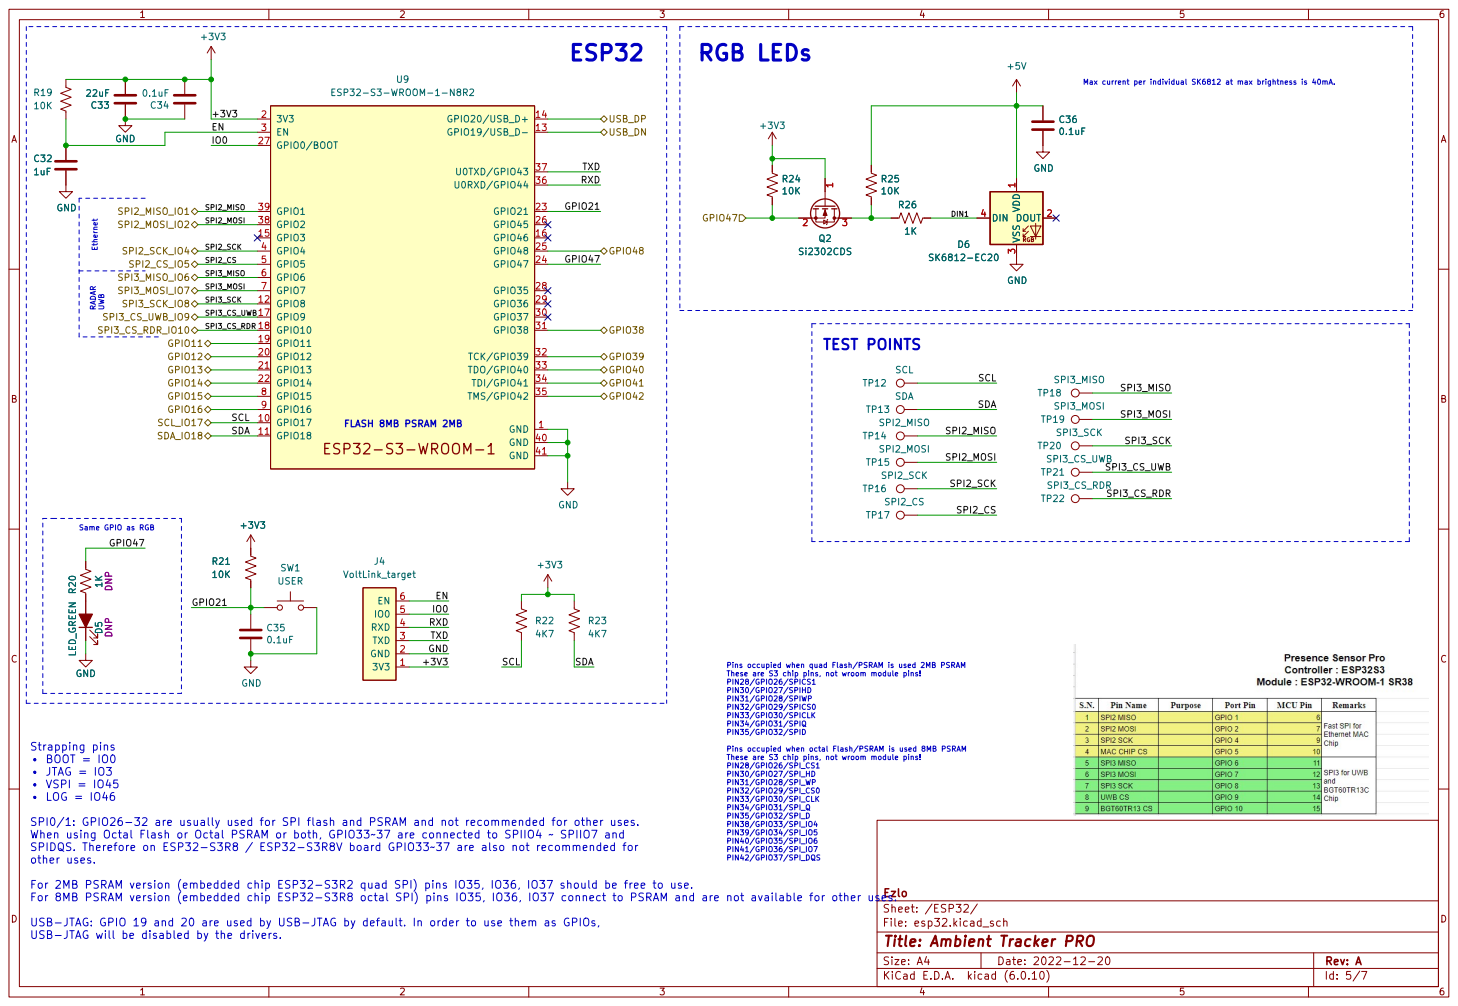
[picture p7: page 5]

Max current per individual SK6812 at max brightness is 40mA. FLASH 8MB PSRAM 2MB Strapping pins

Pins occupied when quad Flash/PSRAM is used 2MB PSRAM
These are S3 chip pins, not wroom module pins! PIN28/GPIO26/SPICS1 PIN30/GPIO27/SPIHD

Pins occupied when octal Flash/PSRAM is used 8MB PSRAM
These are S3 chip pins, not wroom module pins! PIN28/GPIO26/SPI_CS1 PIN30/GPIO27/SPI_HD

SPI0/1: GPIO26-32 are usually used for SPI flash and PSRAM and not recommended for other uses.
When using Octal Flash or Octal PSRAM or both, GPIO33~37 are connected to SPIIO4 ~ SPIIO7 and
SPIDQS. Therefore on ESP32-S3R8 / ESP32-S3R8V board GPIO33~37 are also not recommended for other uses. For 2MB PSRAM version (embedded chip ESP32-S3R2 quad SPI) pins IO35, IO36, IO37 should be free to use.

For 8MB PSRAM version (embedded chip ESP32-S3R8 octal SPI) pins IO35, IO36, IO37 connect to PSRAM and are not available for other uses.

USB-JTAG: GPIO 19 and 20 are used by USB-JTAG by default. In order to use them as GPIOs,

Id: 5/7 Title: Ambient Tracker PRO

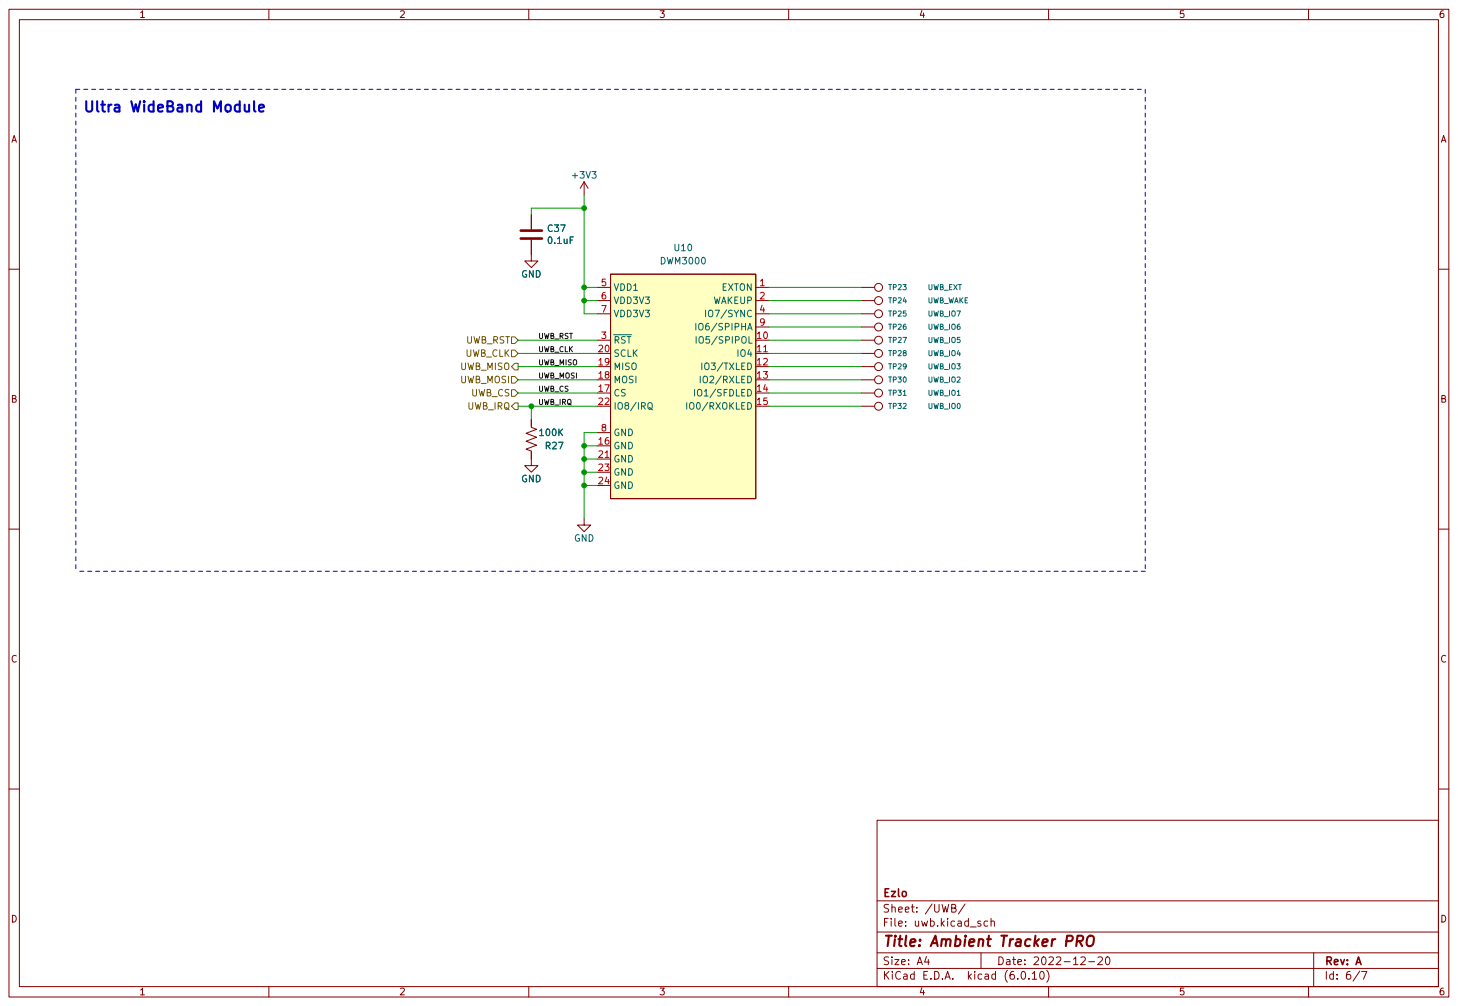
[picture p8: page 6]

File: uwb.kicad_sch Sheet: /UWB/ Ezlo

Id: 6/7 Title: Ambient Tracker PRO

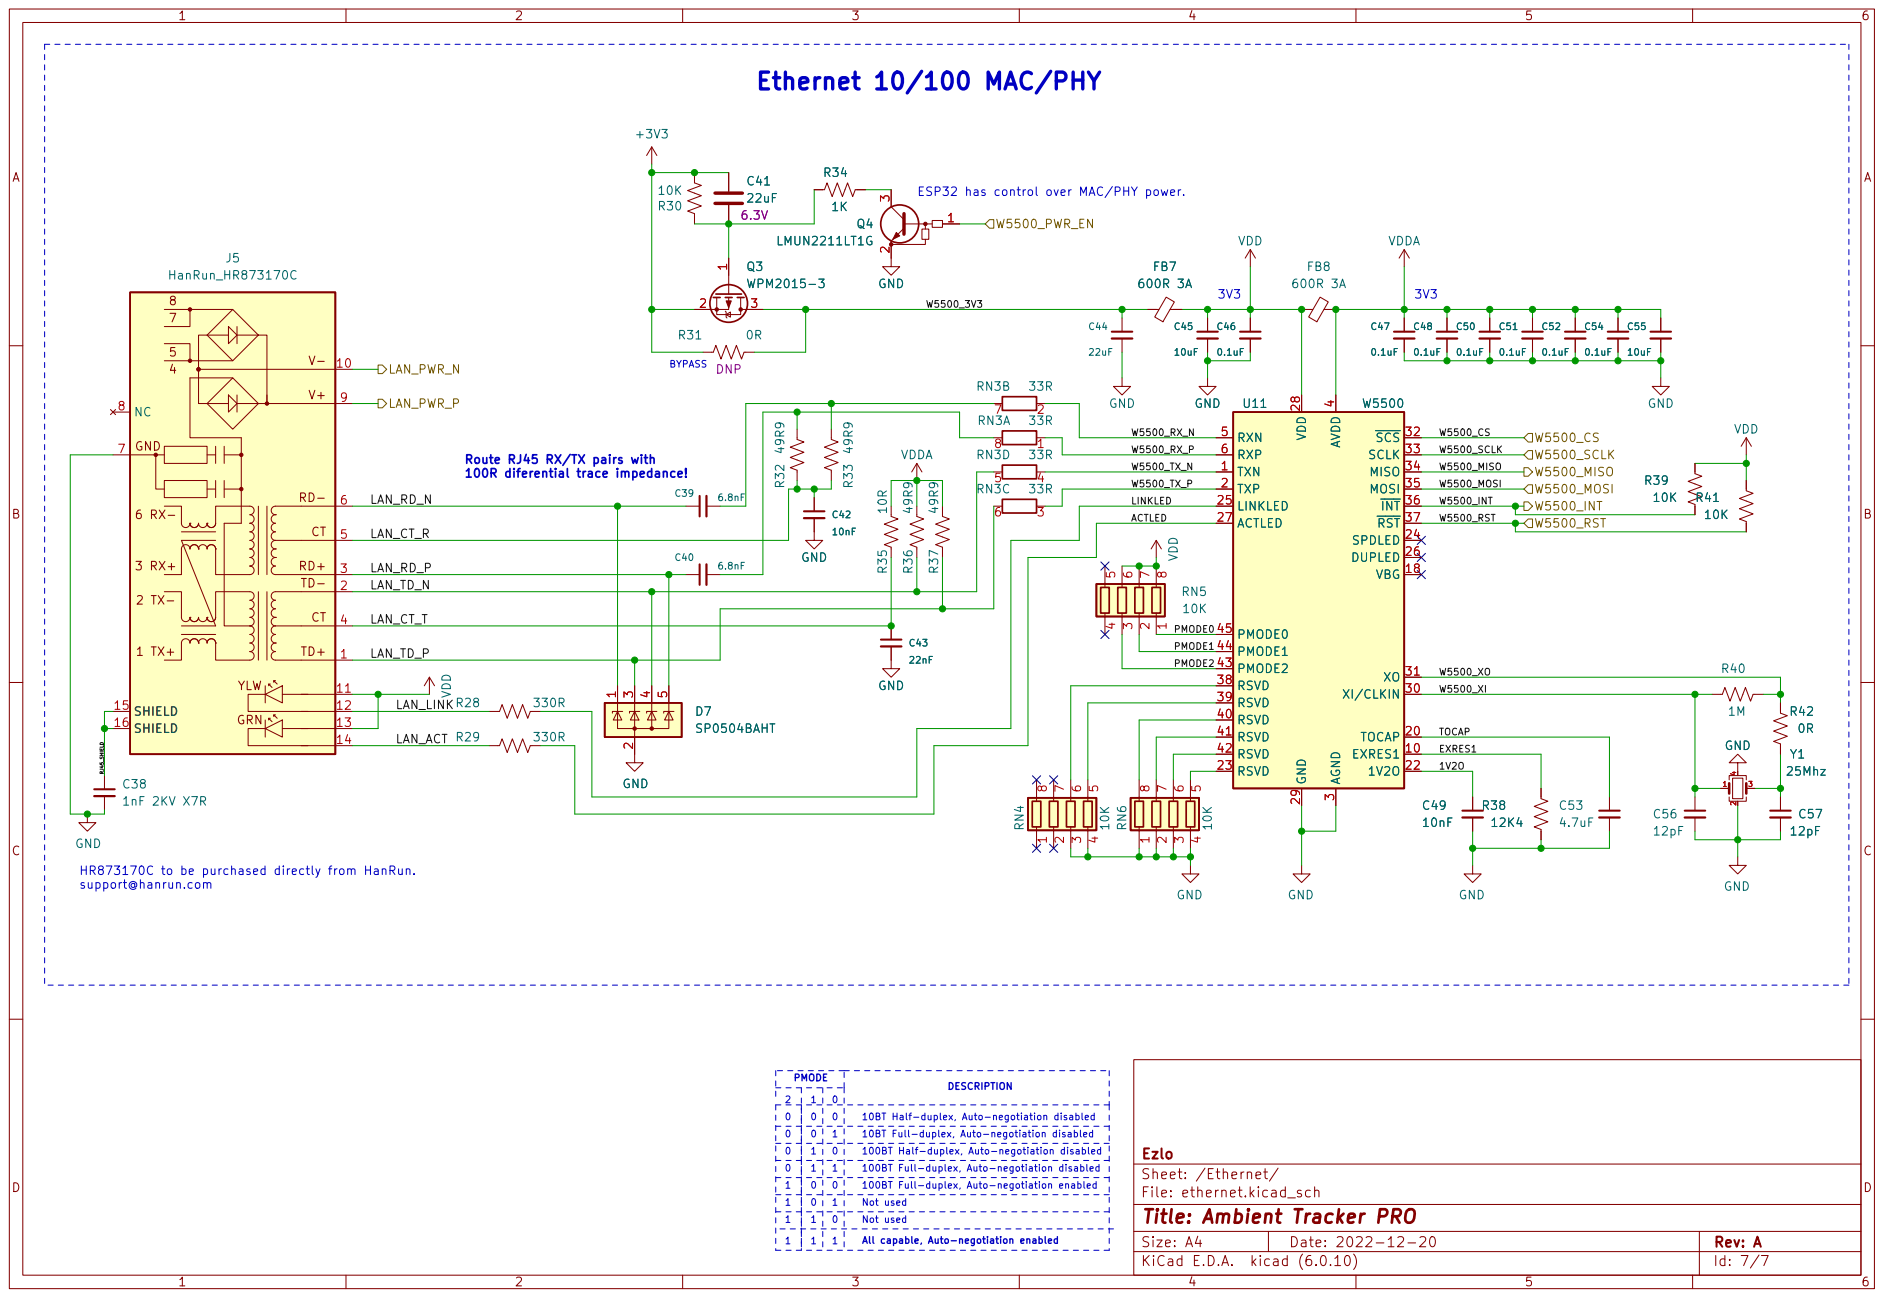
[picture p9: page 7]

ESP32 has control over MAC/PHY power.

4 RSVD 40 RSVD 41 RSVD 42 PMODE2 43 PMODE1 44 PMODE0 45 RXN 5 RXP 6 Q4

4 RSVD 40 RSVD 41 RSVD 42 PMODE2 43 PMODE1 44 PMODE0 45 RXN 5 RXP 6 U11 W5500 C49

3 XI/CLKIN 30 XO 31 ~{SCS}32 SCLK 33 MISO 34 MOSI 35 ~{INT}36 ~{RST}37 RSVD 38 RSVD 39 AVDD

Route RJ45 RX/TX pairs with
100R diferential trace impedance!

100BT Half-duplex, Auto-negotiation disabled HR873170C to be purchased directly from HanRun.
support@hanrun.com

PMODE | 10BT Full-duplex, Auto-negotiation disabled DESCRIPTION

0 | 1 | 0 | 10BT Half-duplex, Auto-negotiation disabled All capable, Auto-negotiation enabled Not used

File: ethernet.kicad_sch Sheet: /Ethernet/ Ezlo

1 | 0 | 0 | 100BT Full-duplex, Auto-negotiation enabled Not used

Id: 7/7 Title: Ambient Tracker PRO
