eSpark-Backup/ezlo-ambienttrackerpro/(list of files, drawings)

Other design files:
Design-Files/Main-Board-v1.0/AmbientPro_Main_Board_V1.0.PcbDoc
Design-Files/Main-Board-v1.0/ESP32-Sheet.SchDoc
Design-Files/Main-Board-v1.0/Ethernet-Sheet.SchDoc
Design-Files/Main-Board-v1.0/Level_Shifter_Sheet.SchDoc
Design-Files/Main-Board-v1.0/Main-Board-v1.0.PrjPcb
Design-Files/Main-Board-v1.0/Power-Sheet.SchDoc
Design-Files/Main-Board-v1.0/Sensor-Sheet.SchDoc
Design-Files/Main-Board-v1.0/Top-Sheet.SchDoc
Design-Files/Main-Board-v1.0/UWB-Sheet.SchDoc
Design-Files/Secondary-Board-v1.0/AmbientPro_Secondary_Board_V1.0.PcbDoc
Design-Files/Secondary-Board-v1.0/Secondary-Board-Sheet.SchDoc
Design-Files/Secondary-Board-v1.0/Secondary-Board-v1.0.PrjPcb
