eSpark-Backup/ezlo-ambienttrackerpro/Client-Files/Ambient Tracker PRO/tracker-pro.kicad_pcb

## KiCad design Client-Files/Ambient Tracker PRO/tracker-pro.kicad_pcb (2023-11-03)

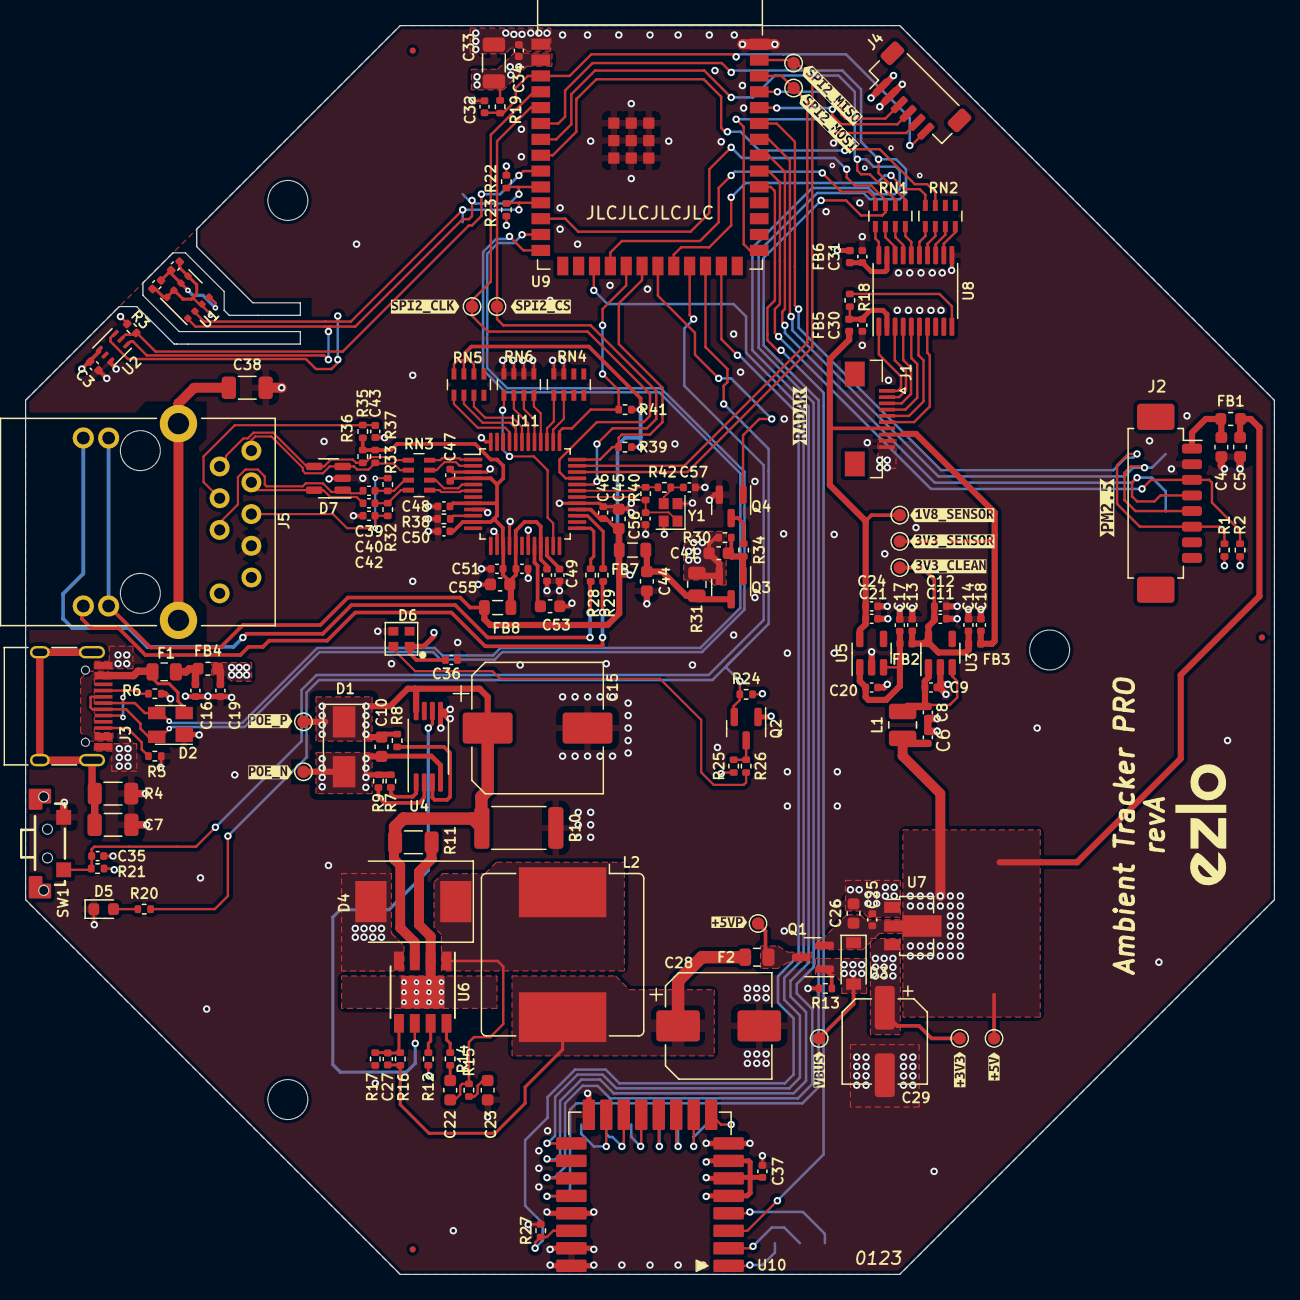
[picture p10: board tracker-pro.kicad_pcb from above]

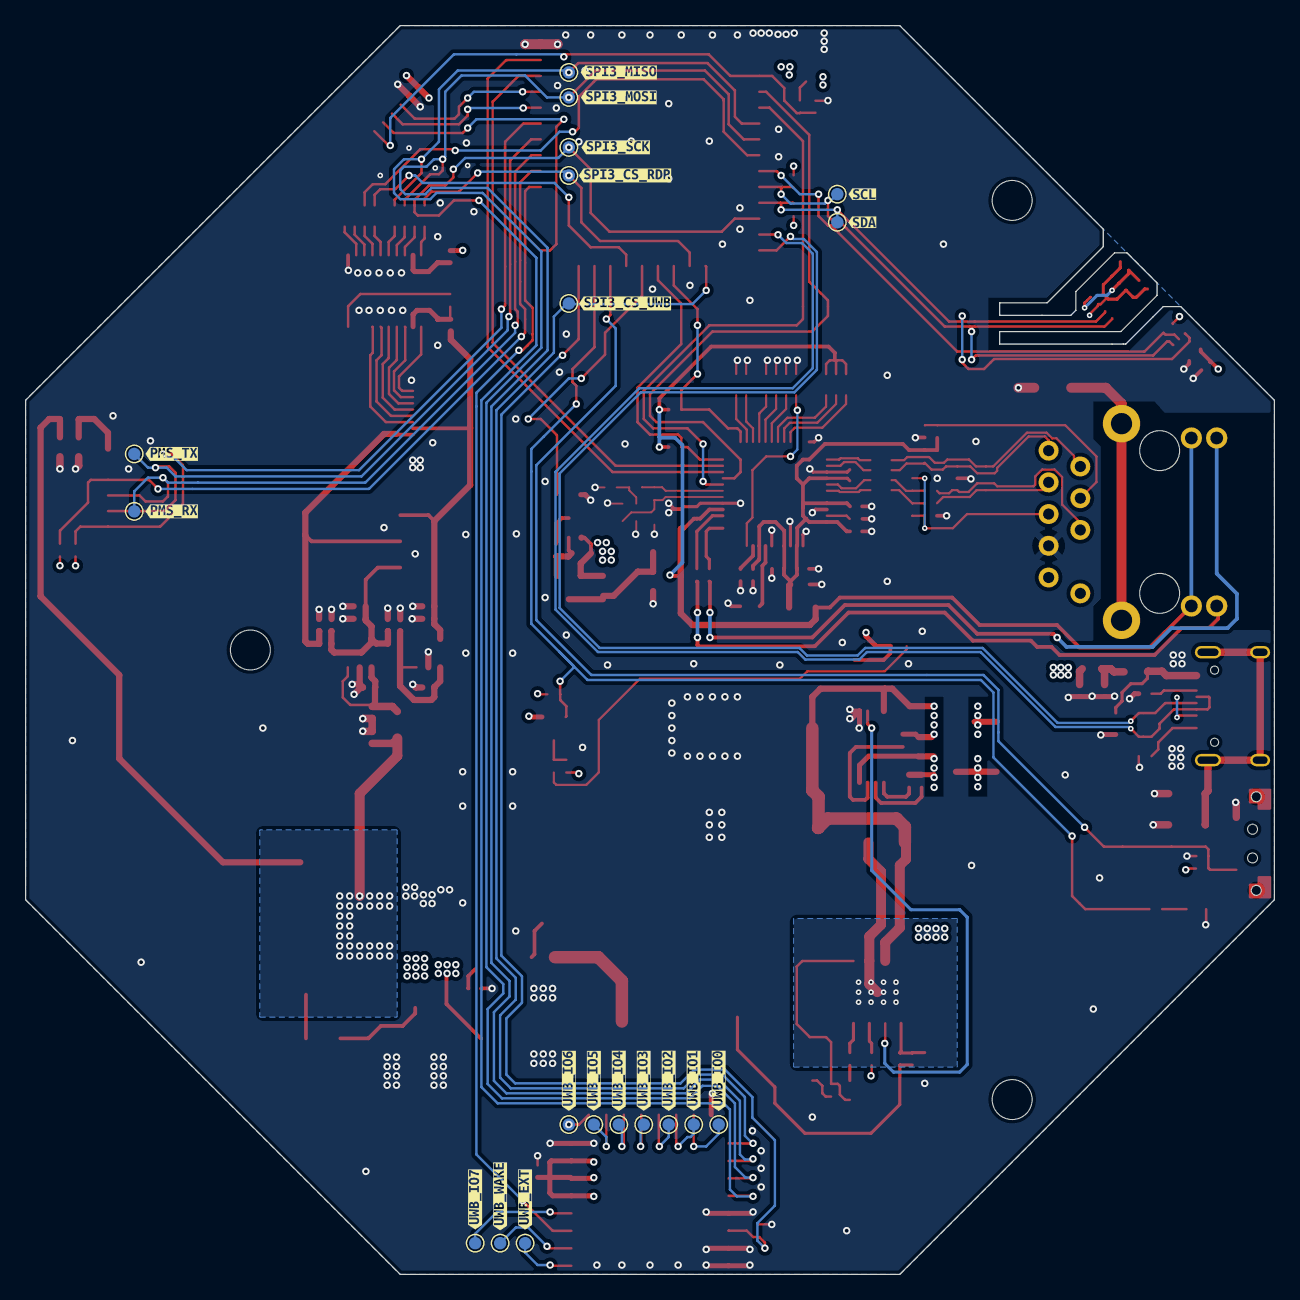
[picture p11: board tracker-pro.kicad_pcb from below]

Board: 4 copper layers, 100.0 x 100.0 mm, 220 parts (38 on the bottom side), 128 nets.

Parts:
C1, C2, C9, C11, C13, C14, C18, C19, C20, C21, C25, C30, C31, C34, C35, C36, C37, C46, C47, C48, C50, C51, C52, C54: 0.1uF; C_0402_1005Metric
C3, C32: 1uF; C_0402_1005Metric
C4, C5, C26, C45, C55: 10uF; C_0603_1608Metric
C6, C8, C12, C17, C24: 10uF; C_0402_1005Metric
C7: 4.7nF; C_1206_3216Metric
C10, C22: 0.1uF; C_0603_1608Metric
C15: 15uF; CP_Elec_10x10
C16: 0.01uF; C_0402_1005Metric
C23: 220pF; C_0603_1608Metric
C27, C56, C57: 12pF; C_0402_1005Metric
C28: 470uF; CP_Elec_8x10
C29: 100uF; CP_Elec_6.3x5.8
C33: 22uF; C_1206_3216Metric
C38: 1nF 2KV X7R; C_1206_3216Metric
C39, C40: 6.8nF; C_0402_1005Metric
C41, C44: 22uF; C_0603_1608Metric
C42, C49: 10nF; C_0402_1005Metric
C43: 22nF; C_0402_1005Metric
C53: 4.7uF; C_0603_1608Metric
D1: SMAJ58A; D_SMA
D2: SP0503BAHT; SOT-143
D3: PMEG4030ER; D_SOD-123
D4: SS510; D_SMC
D5: LED_GREEN; LED_0603_1608Metric
D6: SK6812-EC20; sk6812-2020
D7: SP0504BAHT; SOT-23-5
F1, F2: 1A; Fuse_0805_2012Metric
FB1, FB4: BLM18SG121TN1D; L_0603_1608Metric
FB2, FB3, FB5, FB6: BLM15PD121SN1B; L_0402_1005Metric
FB7, FB8: 600R 3A; L_0805_2012Metric
FID1, FID2, FID3: Fiducial; Fiducial_0.5mm_Mask1mm
H1, H2, H3: MountingHole; MountingHole_3.2mm_M3_DIN965
J1: Conn_01x10; AFC01-S10FCC-00_1x10_P0.5mm_Horizontal
J2: PMS5003; Molex_PicoBlade_53261-0871_1x08-1MP_P1.25mm_Horizontal
J3: USB_C_Receptacle_USB2.0; USB_C_Receptacle_HRO_TYPE-C-31-M-12
J4: VoltLink_target; VoltLink-vertical
J5: HanRun_HR873170C
L1: 10uH; L_1008_2520Metric
L2: 33uH 2A; L_Bourns_SRR1208_12.7x12.7mm
N1: Housing; ambient_tracker_pro_revA_enclosure
Q1: SI2323DS; SOT-23
Q2: Si2302CDS; SOT-23
Q3: WPM2015-3; SOT-23
Q4: LMUN2211LT1G; SOT-23
R1, R2, R3, R12, R19, R21, R24, R25, R30, R39, R41: 10K; R_0402_1005Metric
R4: 1M; R_1206_3216Metric
R5, R6: 5K1; R_0402_1005Metric
R7: 180K; R_0402_1005Metric
R8: 24K9; R_0402_1005Metric
R9: 4K42; R_0402_1005Metric
R10: 4K7; R_2512_6332Metric
R11: 0.03R; R_1206_3216Metric
R13, R27: 100K; R_0402_1005Metric
R14: 4R7; R_0402_1005Metric
R15: 22R; R_0402_1005Metric
R16: 300K; R_0402_1005Metric
R17: 57K1; R_0402_1005Metric
R18, R42: 0R; R_0402_1005Metric
R20, R26, R34: 1K; R_0402_1005Metric
R22, R23: 4K7; R_0402_1005Metric
R28, R29: 330R; R_0402_1005Metric
R31: 0R; R_0805_2012Metric
R32, R33, R36, R37: 49R9; R_0402_1005Metric
R35: 10R; R_0402_1005Metric
R38: 12K4; R_0402_1005Metric
R40: 1M; R_0402_1005Metric
RN1, RN2: 0R; R_Array_Concave_4x0603
RN3: 33R; R_Array_Concave_4x0603
RN4, RN5, RN6: 10K; R_Array_Concave_4x0603
SW1: USER; Switch_YTS-B003-2A
TP1: PMS_TX; TestPoint_Pad_D1.0mm
TP2: PMS_RX; TestPoint_Pad_D1.0mm
TP3: POE_P; TestPoint_Pad_D1.0mm
TP4: POE_N; TestPoint_Pad_D1.0mm
TP5: 3V3_C; TestPoint_Pad_D1.0mm
TP6: 3V3_S; TestPoint_Pad_D1.0mm
TP7: VBUS; TestPoint_Pad_D1.0mm
TP8: 1V8_S; TestPoint_Pad_D1.0mm
TP9: +5V; TestPoint_Pad_D1.0mm
TP10: 3V3; TestPoint_Pad_D1.0mm
TP11: 5VP; TestPoint_Pad_D1.0mm
TP12: SCL; TestPoint_Pad_D1.0mm
TP13: SDA; TestPoint_Pad_D1.0mm
TP14: SPI2_MISO; TestPoint_Pad_D1.0mm
TP15: SPI2_MOSI; TestPoint_Pad_D1.0mm
TP16: SPI2_SCK; TestPoint_Pad_D1.0mm
TP17: SPI2_CS; TestPoint_Pad_D1.0mm
TP18: SPI3_MISO; TestPoint_Pad_D1.0mm
TP19: SPI3_MOSI; TestPoint_Pad_D1.0mm
TP20: SPI3_SCK; TestPoint_Pad_D1.0mm
TP21: SPI3_CS_UWB; TestPoint_Pad_D1.0mm
TP22: SPI3_CS_RDR; TestPoint_Pad_D1.0mm
TP23: UWB_EXT; TestPoint_Pad_D1.0mm
TP24: UWB_WAKE; TestPoint_Pad_D1.0mm
TP25: UWB_IO7; TestPoint_Pad_D1.0mm
TP26: UWB_IO6; TestPoint_Pad_D1.0mm
TP27: UWB_IO5; TestPoint_Pad_D1.0mm
TP28: UWB_IO4; TestPoint_Pad_D1.0mm
TP29: UWB_IO3; TestPoint_Pad_D1.0mm
TP30: UWB_IO2; TestPoint_Pad_D1.0mm
TP31: UWB_IO1; TestPoint_Pad_D1.0mm
TP32: UWB_IO0; TestPoint_Pad_D1.0mm
U1: BME680; Bosch_LGA-8_3x3mm_P0.8mm_ClockwisePinNumbering
U2: LTR-303ALS-01; Lite-On_LTR-303ALS-01
U3: XC6228D332VR-G; SOT-23-5
U4: TPS2375PW-1; TSSOP-8_4.4x3mm_P0.65mm
U5: XC6228D182VR-G; SOT-23-5
U6: TX4138; Diodes_SO-8EP
U7: LR1107; SOT-89-3
U8: TXS0108EPWR; TSSOP-20_4.4x6.5mm_P0.65mm
U9: ESP32-S3-WROOM-1-N8R2; ESP32-S3-WROOM-1
U10: DWM3000; Qorvo_DWM3000
U11: W5500; LQFP-48_7x7mm_P0.5mm
V1: EZLO_LOGO; Logo Ezlo_M
Y1: 25Mhz; Crystal_SMD_2016-4Pin_2.0x1.6mm
kibuzzard-63AACF69: G***; kibuzzard-63AACF69
kibuzzard-63AACF76: G***; kibuzzard-63AACF76
kibuzzard-63AACFD0: G***; kibuzzard-63AACFD0
kibuzzard-63AAD0AA: G***; kibuzzard-63AAD0AA
kibuzzard-63AAD00B: G***; kibuzzard-63AAD00B
kibuzzard-63AAD0BE: G***; kibuzzard-63AAD0BE
kibuzzard-63AAD0D4: G***; kibuzzard-63AAD0D4
kibuzzard-63AAD0DC: G***; kibuzzard-63AAD0DC
kibuzzard-63AAD001: G***; kibuzzard-63AAD001
kibuzzard-63AAD1C0: G***; kibuzzard-63AAD1C0
kibuzzard-63AAD1D3: G***; kibuzzard-63AAD1D3
kibuzzard-63AAD1FD: G***; kibuzzard-63AAD1FD
kibuzzard-63AAD2A3: G***; kibuzzard-63AAD2A3
kibuzzard-63AAD2C0: G***; kibuzzard-63AAD2C0
kibuzzard-63AAD2D7: G***; kibuzzard-63AAD2D7
kibuzzard-63AAD02E: G***; kibuzzard-63AAD02E
kibuzzard-63AAD07E: G***; kibuzzard-63AAD07E
kibuzzard-63AAD16B: G***; kibuzzard-63AAD16B
kibuzzard-63AAD19E: G***; kibuzzard-63AAD19E
kibuzzard-63AAD20D: G***; kibuzzard-63AAD20D
kibuzzard-63AAD21C: G***; kibuzzard-63AAD21C
kibuzzard-63AAD27D: G***; kibuzzard-63AAD27D
kibuzzard-63AAD32F: G***; kibuzzard-63AAD32F
kibuzzard-63AAD33F: G***; kibuzzard-63AAD33F
kibuzzard-63AAD039: G***; kibuzzard-63AAD039
kibuzzard-63AAD045: G***; kibuzzard-63AAD045
kibuzzard-63AAD061: G***; kibuzzard-63AAD061
kibuzzard-63AAD088: G***; kibuzzard-63AAD088
kibuzzard-63AAD273: G***; kibuzzard-63AAD273
kibuzzard-63AAD309: G***; kibuzzard-63AAD309
kibuzzard-63AAD314: G***; kibuzzard-63AAD314
kibuzzard-63AAD337: G***; kibuzzard-63AAD337
kibuzzard-63AAD348: G***; kibuzzard-63AAD348
kibuzzard-63AAD350: G***; kibuzzard-63AAD350

Connections:
1V8_SENSOR: C21.1, C24.1, FB5.2, J1.7, TP8.1, U5.5 (VOUT)
3V3_SENSOR: C18.1, FB3.2, J1.8, TP6.1
+3V3: C1.2, C2.1, C3.1, C29.1, C33.2, C34.2, C37.1, C41.1, FB6.1, J4.1 (3V3), Q2.1 (G), Q3.2 (S), R1.1, R2.1, R3.1, R12.2, R19.2, R21.2, R22.2, R23.2, R24.1, R30.2, R31.1, TP10.1, U1.2 (CSB), U1.5 (SDO), U1.6 (VDDIO), U1.8 (VDD), U2.1 (VDD), U7.3 (VOUT), U9.2 (3V3), U10.5 (VDD1), U10.6 (VDD3V3), U10.7 (VDD3V3)
+5V: C5.1, C6.1, C25.1, C26.1, C36.1, D3.1 (K), D6.1 (VDD), FB1.2, L1.1, Q1.2 (S), R25.1, TP9.1, U7.2 (VIN)
+5VP: F2.1, Q1.3 (D), TP11.1
/ESP32/DIN1: D6.4 (DIN), R26.2
/ESP32/EN: C32.1, J4.6 (EN), R19.1, U9.3 (EN)
/ESP32/GPIO13: Q4.1 (B), U9.21 (GPIO13)
/ESP32/GPIO14: RN2.4 (R4.1), U9.22 (GPIO14)
/ESP32/GPIO15: RN2.3 (R3.1), U9.8 (GPIO15)
/ESP32/GPIO21: C35.1, R21.1, SW1.1, U9.23 (GPIO21)
/ESP32/GPIO47: Q2.2 (S), R20.1, R24.2, U9.24 (GPIO47)
/ESP32/IO0: J4.5 (IO0), U9.27 (GPIO0/BOOT)
/ESP32/RXD: J4.4 (RXD), U9.36 (U0RXD/GPIO44)
/ESP32/SCL: R22.1, TP12.1, U1.4 (SCK), U2.4 (SCL), U9.10 (GPIO17)
/ESP32/SDA: R23.1, TP13.1, U1.3 (SDI), U2.6 (SDA), U9.11 (GPIO18)
/ESP32/SPI2_CS: TP17.1, U9.5 (GPIO5), U11.32 (~SCS)
/ESP32/SPI2_MISO: TP14.1, U9.39 (GPIO1), U11.34 (MISO)
/ESP32/SPI2_MOSI: TP15.1, U9.38 (GPIO2), U11.35 (MOSI)
/ESP32/SPI2_SCK: TP16.1, U9.4 (GPIO4), U11.33 (SCLK)
/ESP32/SPI3_CS_RDR: RN1.4 (R4.1), TP22.1, U9.18 (GPIO10)
/ESP32/SPI3_CS_UWB: TP21.1, U9.17 (GPIO9), U10.17 (CS)
/ESP32/SPI3_MISO: RN1.1 (R1.1), TP18.1, U9.6 (GPIO6), U10.19 (MISO)
/ESP32/SPI3_MOSI: RN1.2 (R2.1), TP19.1, U9.7 (GPIO7), U10.18 (MOSI)
/ESP32/SPI3_SCK: RN1.3 (R3.1), TP20.1, U9.12 (GPIO8), U10.20 (SCLK)
/ESP32/TXD: J4.3 (TXD), U9.37 (U0TXD/GPIO43)
/Ethernet/1V2O: C49.1, U11.22 (1V2O)
/Ethernet/ACTLED: R29.2, U11.27 (ACTLED)
/Ethernet/EXRES1: R38.2, U11.10 (EXRES1)
/Ethernet/LAN_ACT: J5.14, R29.1
/Ethernet/LAN_CT_R: C42.1, J5.5, R32.2, R33.2
/Ethernet/LAN_CT_T: C43.1, J5.4, R35.2
/Ethernet/LAN_LINK: J5.12, R28.1
/Ethernet/LAN_PWR_N: C10.2, D1.2 (A), J5.10, R7.2, R9.2, TP4.1, U4.4 (VSS)
/Ethernet/LAN_RD_N: C39.1, D7.1 (K), J5.6
/Ethernet/LAN_RD_P: C40.1, D7.5 (K), J5.3
/Ethernet/LAN_TD_N: D7.4 (K), J5.2, R36.2, RN3.5 (R4.2)
/Ethernet/LAN_TD_P: D7.3 (K), J5.1, R37.2, RN3.6 (R3.2)
/Ethernet/LINKLED: R28.2, U11.25 (LINKLED)
/Ethernet/PMODE0: RN5.1 (R1.1), U11.45 (PMODE0)
/Ethernet/PMODE1: RN5.2 (R2.1), U11.44 (PMODE1)
/Ethernet/PMODE2: RN5.3 (R3.1), U11.43 (PMODE2)
/Ethernet/RJ45_SHIELD: C38.1, J5.15 (SHIELD), J5.16 (SHIELD)
/Ethernet/TOCAP: C53.1, U11.20 (TOCAP)
/Ethernet/W5500_3V3: C44.1, FB7.1, Q3.3 (D), R31.2
/Ethernet/W5500_INT: R39.1, U9.20 (GPIO12), U11.36 (~INT)
/Ethernet/W5500_RST: R41.1, U9.19 (GPIO11), U11.37 (~RST)
/Ethernet/W5500_RX_N: RN3.2 (R2.1), U11.5 (RXN)
/Ethernet/W5500_RX_P: RN3.1 (R1.1), U11.6 (RXP)
/Ethernet/W5500_TX_N: RN3.4 (R4.1), U11.1 (TXN)
/Ethernet/W5500_TX_P: RN3.3 (R3.1), U11.2 (TXP)
/Ethernet/W5500_XI: C56.1, R40.1, U11.30 (XI/CLKIN), Y1.1
/Ethernet/W5500_XO: R40.2, R42.2, U11.31 (XO)
/Level shifter/SPI_OE: R18.1, U8.10 (OE)
/Level shifter/VCCA: C30.1, FB5.1, R18.2, U8.2 (VCCA)
/Level shifter/VCCB: C31.1, FB6.2, U8.19 (VCCB)
/Power-Interface/3V3_CLEAN: C11.1, C12.1, C13.1, C14.1, FB2.1, FB3.1, TP5.1, U3.5 (VOUT)
/Power-Interface/3V3_LDO1V8: C17.1, C20.1, FB2.2, U5.1 (VIN), U5.3 (CE)
/Power-Interface/CC1: J3.A5 (CC1), R6.1
/Power-Interface/CC2: J3.B5 (CC2), R5.1
/Power-Interface/DCDC_BS: R14.2, U6.8 (BS)
/Power-Interface/DCDC_FB: C27.2, R16.1, R17.2, U6.5 (FB)
/Power-Interface/DCDC_ILIM: R11.1, U6.2 (ILIM), U6.9 (ILIM)
/Power-Interface/DCDC_OUT: C27.1, C28.1, F2.2, L2.2, R16.2
/Power-Interface/DCDC_POK: R12.1, U6.7 (POK)
/Power-Interface/DCDC_SW: C22.2, D4.1 (K), L2.1, R15.2, U6.1 (SW)
/Power-Interface/DCDC_VIN: C10.1, C15.1, D1.1 (K), J5.9, R8.1, R10.2, R11.2, TP3.1, U4.8 (VDD), U6.3 (VIN)
/Power-Interface/POE_EN_DCDC: U4.6 (PG), U6.6 (EN)
/Power-Interface/USB_D_N: D2.4 (K), J3.A7 (D-), J3.B7 (D-), U9.13 (GPIO19/USB_D-)
/Power-Interface/USB_D_P: D2.3 (K), J3.A6 (D+), J3.B6 (D+), U9.14 (GPIO20/USB_D+)
/Power-Interface/VIN_CLEAN: C8.1, C9.1, L1.2, U3.1 (VIN), U3.3 (CE)
/Power-Interface/V_USB: D2.2 (K), F1.2, J3.A4 (VBUS), J3.A9 (VBUS), J3.B4 (VBUS), J3.B9 (VBUS)
/Sensors/BGT_CLK: J1.2, U8.3 (A2)
/Sensors/BGT_CS: J1.1, U8.1 (A1)
/Sensors/BGT_IRQ: J1.6, U8.7 (A6)
/Sensors/BGT_MISO: J1.4, U8.5 (A4)
/Sensors/BGT_MOSI: J1.3, U8.4 (A3)
/Sensors/BGT_RST: J1.5, U8.6 (A5)
/Sensors/INT_ALS: R3.2, U2.5 (INT), U9.9 (GPIO16)
/Sensors/PMS_5V: C4.1, FB1.1, J2.1
/Sensors/PMS_RST: J2.6, R1.2, U9.35 (TMS/GPIO42)
/Sensors/PMS_RX: J2.4, TP2.1, U9.33 (TDO/GPIO40)
/Sensors/PMS_SET: J2.3, R2.2, U9.32 (TCK/GPIO39)
/Sensors/PMS_TX: J2.5, TP1.1, U9.34 (TDI/GPIO41)
/UWB/UWB_IRQ: R27.1, U9.25 (GPIO48), U10.22 (IO8/IRQ)
/UWB/UWB_RST: U9.31 (GPIO38), U10.3 (~RST)
GND: C1.1, C2.2, C3.2, C4.2, C5.2, C6.2, C7.2, C8.2, C9.2, C11.2, C12.2, C13.2, C14.2, C15.2, C16.2, C17.2, C18.2, C19.2, C20.2, C21.2, C23.1, C24.2, C25.2, C26.2, C28.2, C29.2, C30.2, C31.2, C32.2, C33.1, C34.1, C35.2, C36.2, C37.2, C38.2, C42.2, C43.2, C44.2, C45.2, C46.2, C47.2, C48.2, C49.2, C50.2, C51.2, C52.2, C53.2, C54.2, C55.2, C56.2, C57.2, D2.1 (A), D4.2 (A), D5.1 (K), D6.3 (VSS), D7.2 (A), J1.9, J1.10, J2.2, J3.A1 (GND), J3.A12 (GND), J3.B1 (GND), J3.B12 (GND), J4.2 (GND), J5.7, Q4.2 (E), R4.2, R5.2, R6.2, R10.1, R13.2, R17.1, R27.2, R38.1, RN4.3 (R3.1), RN4.4 (R4.1), RN6.1 (R1.1), RN6.2 (R2.1), RN6.3 (R3.1), RN6.4 (R4.1), SW1.2, U1.1 (GND), U1.7 (GND), U2.3 (GND), U3.2 (GND), U4.5 (RTN), U5.2 (GND), U6.4 (GND), U7.1 (GND), U8.11 (GND), U9.1 (GND), U9.40 (GND), U9.41 (GND), U10.8 (GND), U10.16 (GND), U10.21 (GND), U10.23 (GND), U10.24 (GND), U11.3 (AGND), U11.9 (AGND), U11.14 (AGND), U11.16 (AGND), U11.19 (AGND), U11.29 (GND), U11.48 (AGND), Y1.2, Y1.4
unnamed: C7.1, J3.S1 (SHIELD), R4.1
unnamed: C16.1, F1.1, FB4.1
unnamed: C22.1, R14.1
unnamed: C23.2, R15.1
unnamed: C39.2, R33.1, RN3.7 (R2.2)
unnamed: C40.2, R32.1, RN3.8 (R1.2)
unnamed: C41.2, Q3.1 (G), R30.1, R34.1
unnamed: C57.1, R42.1, Y1.3
unnamed: D5.2 (A), R20.2
unnamed: Q2.3 (D), R25.2, R26.1
unnamed: Q4.3 (C), R34.2
unnamed: R7.1, U4.1 (ILIM)
unnamed: R8.2, U4.3 (DET)
unnamed: R9.1, U4.2 (CLASS)
unnamed: RN1.5 (R4.2), U8.20 (B1)
unnamed: RN1.6 (R3.2), U8.18 (B2)
unnamed: RN1.7 (R2.2), U8.17 (B3)
unnamed: RN1.8 (R1.2), U8.16 (B4)
unnamed: RN2.5 (R4.2), U8.15 (B5)
unnamed: RN2.6 (R3.2), U8.14 (B6)
unnamed: RN2.7 (R2.2), U8.13 (B7)
unnamed: RN2.8 (R1.2), U8.12 (B8)
unnamed: RN4.5 (R4.2), U11.39 (RSVD)
unnamed: RN4.6 (R3.2), U11.38 (RSVD)
unnamed: RN6.5 (R4.2), U11.23 (RSVD)
unnamed: RN6.6 (R3.2), U11.42 (RSVD)
unnamed: RN6.7 (R2.2), U11.41 (RSVD)
unnamed: RN6.8 (R1.2), U11.40 (RSVD)
unnamed: TP23.1, U10.1 (EXTON)
unnamed: TP24.1, U10.2 (WAKEUP)
unnamed: TP25.1, U10.4 (IO7/SYNC)
unnamed: TP26.1, U10.9 (IO6/SPIPHA)
unnamed: TP27.1, U10.10 (IO5/SPIPOL)
unnamed: TP28.1, U10.11 (IO4)
unnamed: TP29.1, U10.12 (IO3/TXLED)
unnamed: TP30.1, U10.13 (IO2/RXLED)
unnamed: TP31.1, U10.14 (IO1/SFDLED)
unnamed: TP32.1, U10.15 (IO0/RXOKLED)
VBUS: C19.1, D3.2 (A), FB4.2, Q1.1 (G), R13.1, TP7.1
VDD: C45.1, C46.1, FB7.2, FB8.1, J5.11, J5.13, R39.2, R41.2, RN5.6 (R3.2), RN5.7 (R2.2), RN5.8 (R1.2), U11.28 (VDD)
VDDA: C47.1, C48.1, C50.1, C51.1, C52.1, C54.1, C55.1, FB8.2, R35.1, R36.1, R37.1, U11.4 (AVDD), U11.8 (AVDD), U11.11 (AVDD), U11.15 (AVDD), U11.17 (AVDD), U11.21 (AVDD)
