eSpark-Backup/ezlo-ambienttrackerpro/(commit log)

2023-11-03 gitignore, client files added
    [JLCPCB_position_revB.xlsx, JLCSMT_BOM_tracker_revA.xlsx, TX4138 calculator.xlsx, esp32.kicad_sch, ethernet.kicad_sch, level_shift.kicad_sch, power.kicad_sch, sensors.kicad_sch]
2023-11-03 Branch and files added
    [Main-Board-v1.0.PrjPcb, Secondary-Board-Sheet.SchDoc, Secondary-Board-v1.0.PrjPcb, Sensors-Sheet.SchDoc, Top-Sheet.SchDoc]
2023-11-06 #1 Schematic In Progress.
    [ESP32-Sheet.SchDoc, Ethernet-Sheet.SchDoc, Level_Shifter_Sheet.SchDoc, Main-Board-v1.0.PrjPcb, Power-Sheet.SchDoc, Sensor-Sheet.SchDoc, Sensors-Sheet.SchDoc]
2023-11-13 #1 Schematic completed.
    [ESP32-Sheet.SchDoc, Ethernet-Sheet.SchDoc, Level_Shifter_Sheet.SchDoc, Main-Board-v1.0.PrjPcb, Power-Sheet.SchDoc, Sensor-Sheet.SchDoc, Top-Sheet.SchDoc, UWB-Sheet.SchDoc]
2023-11-14 #1 Power sheet C2 and C5 value changed
    [Power-Sheet.SchDoc, Sensor-Sheet.SchDoc, Top-Sheet.SchDoc]
2023-11-16 #2 Schematic Completed.
    [AmbientPro_Main_Board_V1.0.PcbDoc, Main-Board-v1.0.PrjPcb, Secondary-Board-Sheet.SchDoc, Secondary-Board-v1.0.PrjPcb, Sensor-Sheet.SchDoc]
2023-11-16 #1 Library source changed from "eSpark Centralized" to "eSpark Libraries"
    [ESP32-Sheet.SchDoc, Ethernet-Sheet.SchDoc, Level_Shifter_Sheet.SchDoc, Power-Sheet.SchDoc, Sensor-Sheet.SchDoc, UWB-Sheet.SchDoc]
2023-11-16 #3 Placement started
    [AmbientPro_Main_Board_V1.0.PcbDoc]
2023-11-17 #1 Designators assigned in POE circuitry. Capacitor and Resistor net assigned to USB shield pins.
    [Ethernet-Sheet.SchDoc, Power-Sheet.SchDoc]
2023-11-17 #3 Placement in progress
    [AmbientPro_Main_Board_V1.0.PcbDoc, Power-Sheet.SchDoc]
2023-11-17 #5 eSpark BOM In Progress
    [eSpark-BOM-Main-Board-v1.0.xlsx]
2023-11-20 #3 Placement completed.
    [AmbientPro_Main_Board_V1.0.PcbDoc]
2023-11-20 #1 Switch debounce cap and pull up resistor had no connection with the switch. Corrected.
    [ESP32-Sheet.SchDoc]
2023-11-21 #3 Routing in progress
    [AmbientPro_Main_Board_V1.0.PcbDoc]
2023-11-22 #3 Routing almost done. PWR, GND, DRC and Overlays remaining.
    [AmbientPro_Main_Board_V1.0.PcbDoc]
2023-11-23 #3 DRC rermaining
    [AmbientPro_Main_Board_V1.0.PcbDoc]
2023-11-24 #3 Routing done. It just needs a review from my side.
    [AmbientPro_Main_Board_V1.0.PcbDoc, Main-Board-v1.0.PrjPcb]
2023-11-27 #4 Placement and Designing in progress!
    [AmbientPro_Secondary_Board_V1.0.PcbDoc, Secondary-Board-Sheet.SchDoc, Secondary-Board-v1.0.PrjPcb]
2023-11-28 #1 SW1 part changed
    [ESP32-Sheet.SchDoc]
2023-11-28 #4 Routing completed. PCB needs verification with the enclosure
    [Secondary-Board-v1.0.PrjPcb]
2023-11-28 #3 POE circuitry need to be moved downwards as they are colliding with the PMS in the enclosure.
    [AmbientPro_Main_Board_V1.0.PcbDoc]
2023-11-29 #3 POE components moved as they were colliding with the PMS sensor.
    [AmbientPro_Main_Board_V1.0.PcbDoc, AmbientPro_Main_Board_V1.0.step, AmbientPro_Secondary_Board_V1.0.step]
